periashutosh-prog/Restwise-Watch/README.md

# ⌚ Restwise

**A low-cost, radio-off wellbeing watch for students.**

Restwise shows one thing: today's schedule -- classes, meals, water breaks, and sleep windows -- synced from a companion website over USB and displayed on a small always-available wrist screen. No app to install, no notifications, no phone required to use it day-to-day. It runs on an ESP32-C6, and keeps WiFi and Bluetooth disabled during normal wear by design.

---

## 📋 Table of Contents

- [✨ Key Features](#-key-features)
- [🔩 Hardware Overview](#-hardware-overview)
- [🔌 Pin Mapping](#-pin-mapping)
- [🧠 Firmware Architecture](#-firmware-architecture)
- [🔄 Restwise Sync Protocol](#-restwise-sync-protocol)
- [📁 Repository Structure](#-repository-structure)
- [🛠️ Building & Flashing](#️-building--flashing)
- [📐 Technical Specifications](#-technical-specifications)
- [⚠️ Safety Notice](#️-safety-notice)
- [📄 License](#-license)

---

## ✨ Key Features

- 🔋 **Radio-off by default** -- WiFi and Bluetooth are explicitly disabled at boot (`WiFi.mode(WIFI_OFF); btStop();`), for continuous low-RF wear rather than as a cost-saving measure
- 🖥️ **Standalone timetable display** -- once synced, the watch shows the day's schedule entirely offline, browsable by day (Today, Monday..Saturday)
- 🔁 **Custom USB serial sync protocol** -- a small line-based handshake pushes a full week's schedule from the companion website to the watch in seconds, no companion app required
- 🕒 **RTC with graceful fallback** -- uses a DS3231 real-time clock when present; falls back to a software clock seeded at boot if the RTC isn't detected, so the watch never halts on a missing component
- 🌙 **Good Night screen** -- a passive night-time greeting with a crescent moon, shown automatically during configured night hours
- 🔐 **PIN lock & app suite** -- Stopwatch, Timer (with alert), Calculator (with a scientific mode), a lock-screen PIN gate, and a USB terminal console, all built on the same screen-state-machine UI
- 🔌 **Dual power path** -- runs from USB, battery, or both at once, via a diode-ORed supply feeding a single 3.3V regulator

---

## 🔩 Hardware Overview

| Component | Part |
|---|---|
| MCU | ESP32-C6-MINI-1-N4 |
| Display | 0.96" OLED, 128x64, SSD1306, I2C |
| RTC | DS3231 (optional at boot, software fallback if absent) |
| Input | 5-button D-pad (Up / Down / Left / Right / Center) |
| Regulator | AP2112K-3.3 LDO |
| Charging | External MCP73831-based charger board (see `PCB Files/`) |
| Storage | Onboard flash (LittleFS) for the synced timetable; EEPROM for settings |

---

## 🔌 Pin Mapping

| Signal | GPIO |
|---|---|
| SCL | 6 |
| SDA | 14 |
| Button -- Up | 23 |
| Button -- Down | 21 |
| Button -- Left | 19 |
| Button -- Right | 20 |
| Button -- Center | 3 |

> ℹ️ Only GPIO0-7 sit in the ESP32-C6's low-power (LP) domain and can wake the chip from *deep* sleep. Center (GPIO3) was deliberately placed in that range in case deep-sleep wake-on-press is added later. Light sleep has no such restriction and works on all five button pins.

All buttons are wired active-low to GND with internal pull-ups enabled in firmware -- no external resistors needed.

---

## 🧠 Firmware Architecture

The UI is a **screen-state machine**: a single `ScreenState` enum value tracks what's on screen at any moment, `drawScreen()` dispatches to the matching draw function, and every screen has its own `if/else` block in `loop()` for input handling. Transitions between screens use a simple offset-based slide animation.

**Screens included:** Watchface, Menu, Restwise (timetable + day view), Stopwatch, Timer (+ alert), Calculator (+ scientific mode), PIN entry, Security menu/confirm, Lock-screen settings, Terminal, and the Good Night screen.

Buttons are polled directly in `loop()` (50ms interval, which also serves as debounce) -- there's no RTOS task reading input separately.

---

## 🔄 Restwise Sync Protocol

A small, line-based ASCII protocol runs over the same USB serial connection used for flashing, active on every screen except the Terminal app (which owns Serial for its own console protocol while active):

```
Host -> ESP   RW_HELLO                          ESP -> Host   RW_HELLO
Host -> ESP   RW_TIME <YYYY-MM-DD HH:MM:SS>      ESP -> Host   RW_TIME_OK
Host -> ESP   RW_BEGIN                           ESP -> Host   RW_READY
Host -> ESP   C|<key>|<Name>                     (8 lines: the category names, e.g. C|school|School, C|free|Free time)
Host -> ESP   <days>:<category>|<startMin>|<endMin>|<label>  (repeated, one per line)
Host -> ESP   RW_END                             ESP -> Host   RW_OK <count>
```

`<label>` is the block's name as typed on the website (up to 19 characters, may be empty) and `<category>` is the key chosen in the website's dropdown: `school`, `tuition`, `homework`, `meal`, `break`, `sleep`, `free` or `travel`. The category is written after a colon in the first field so firmware that predates it still reads the day mask and ignores the rest; `C|` lines are skipped by older firmware as well. A block synced without a category (an older timetable) falls back to guessing its icon from the words in its name.

### The current-block screen

On waking from deep sleep (and from idle screen-off) the watch checks the timetable first: if a block is running it shows that block, otherwise the watchface. The screen has an icon on the left chosen by the block's category (book = school, tuition and homework; bowl = meal; moon = sleep; clock = free time; car = travel; bottle = break) and, on the right, the start-end time and the block's name. Only a night Sleep block says "Good Night!". The layout lives in `block_screen.h` and the icons in `block_icons.h` (generated from `UI-Screens/render_engine/block_ui.py`); `host-test/` runs the same code on a PC and checks it pixel-for-pixel against the approved renders.

### Two builds

`build_config.h` has a switch, `RESTWISE_NO_RADIO`. `python tools/build_variants.py both` compiles the full build (WiFi app, Discord, AI Chatbot, NTP) and the **no-radio build**, where none of that code is compiled in, from the same source.

Receiving a handshake auto-navigates the watch to the Restwise screen, since opening the serial port resets the chip back to the watchface. The received schedule is written straight to `/timetable.rw` on LittleFS and reloaded immediately once the transfer completes -- no reboot required.

### The AI chatbot's personality

The chatbot talks like a warm friend rather than a helpdesk: casual and short, on your side, it nudges you to sleep when it is late, and it says so honestly if you ask whether it is an AI. The persona is `AI_PERSONA_BASE` and `AI_PERSONA_STYLE` in `Restwise-watch.ino` (plain ASCII, under 40 words per reply). To make it personal, add an optional `AI_OWNER_PROFILE` to your **private** `ai_config.h` (see `ai_config.example.h`); it is never committed, but it is sent to Groq with every message, so keep it light. Full-radio build only: the no-radio build has no chatbot.

---

## 📁 Repository Structure

```
Restwise-watch/
├── Restwise-watch.ino    # Firmware source (this repo's main sketch)
├── block_screen.h        # Current-block screen, block lookup and name layout (shared with host-test/)
├── block_icons.h         # The six 40x40 block icons (generated)
├── build_config.h        # RESTWISE_NO_RADIO switch
├── tools/                # build_variants.py: compile the full and the no-radio build
├── host-test/            # Runs block_screen.h on a PC and compares it with the approved renders
├── PCB Files/            # Schematic, PCB layout, and Gerber/export files
├── README.md             # This file
└── LICENSE                # All Rights Reserved
```

---

## 🛠️ Building & Flashing

1. Install the **ESP32 board package** in Arduino IDE / `arduino-cli` (board: `esp32:esp32:esp32c6`).
2. Install the required libraries: `RTClib`, `Adafruit SSD1306`, `Adafruit GFX Library`.
3. Open `Restwise-watch.ino` and select the ESP32-C6 board + correct COM port.
4. Compile and upload.

```bash
arduino-cli compile --fqbn esp32:esp32:esp32c6 .
arduino-cli upload -p COMx --fqbn esp32:esp32:esp32c6 .
```

---

## 📐 Technical Specifications

| Spec | Value |
|---|---|
| MCU | ESP32-C6 |
| Flash usage | ~93% of 1.31MB (default partition scheme) |
| RAM usage | ~14% of 320KB |
| Display | 0.96" OLED, 128x64, I2C |
| Sync interface | USB serial (Web Serial API on the website side) |
| Radio | Off by default |

---

## ⚠️ Safety Notice

This project includes custom battery charging circuitry and a lithium battery. Building or operating a device from these files carries real electrical and fire risk if assembled incorrectly. Anyone building this does so entirely at their own risk. See `LICENSE` for the full disclaimer.

---

## 📄 License

**All Rights Reserved.** See [`LICENSE`](./LICENSE) for full terms. This repository is shared for viewing and evaluation only (e.g. school project review, competition judging, sponsorship review) -- no permission is granted to copy, modify, or redistribute any part of it without prior written consent.
