periashutosh-prog/Restwise-Watch/PCB Files/Schematic.pdf

R6

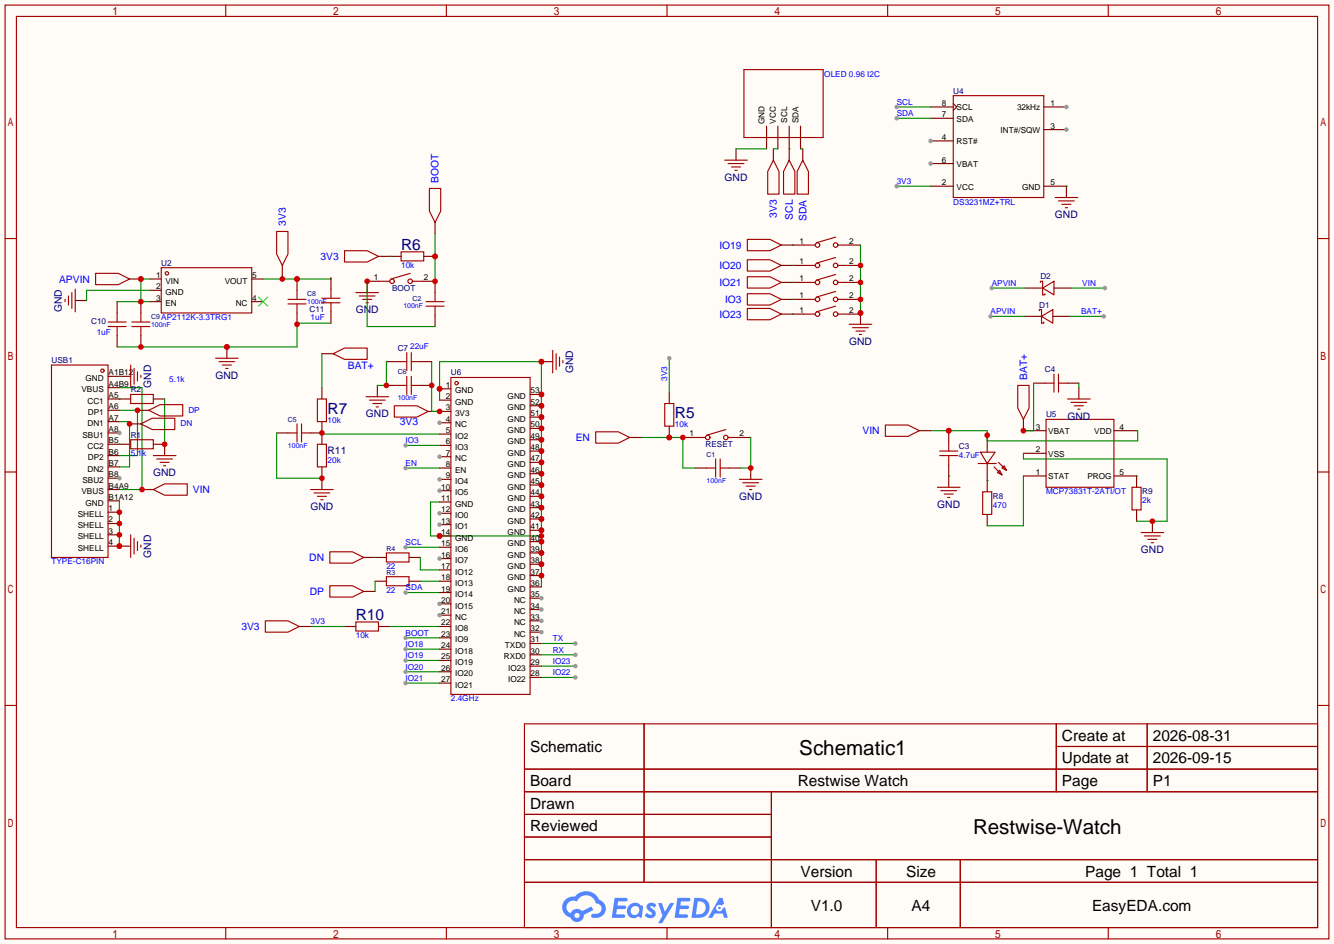
[picture p1: page 1]

Schematic | Schematic1 | Create at | 2026-08-31

Update at | 2026-09-15

Board | Restwise Watch | Page | P1
Drawn | | Restwise-Watch
Reviewed

Version | Size | Page 1 Total 1
V1.0 | A4 | EasyEDA.com
