periashutosh-prog/Restwise-Watch/Restwise-watch.ino

// Restwise - Restwise smartwatch firmware for the ESP32-C6 (custom PCB)
// Copyright (C) 2026 Ashutosh
//
// Port of StrawberryOS8266 (ESP8266 NodeMCU v1) to the ESP32-C6-MINI-1-N4
// custom Restwise PCB. All UI/app code is unchanged from the ESP8266 build;
// only the platform layer differs. See PORTING NOTES below.
//
// See the LICENSE file for more details.
//
// ---------------------------------------------------------------------------
// PORTING NOTES (ESP8266 NodeMCU v1 -> ESP32-C6 custom PCB)
// ---------------------------------------------------------------------------
// * WiFi library is <WiFi.h> (ESP32 core), not <ESP8266WiFi.h>. Radio-off is
//   now WiFi.mode(WIFI_OFF) + btStop() -- the ESP32-C6 also has BLE (unlike
//   the ESP8266), so both radios are explicitly killed, not just WiFi.
//   forceSleepBegin() doesn't exist on ESP32 and isn't needed: WIFI_OFF
//   already fully powers the radio down on this core.
// * EEPROM (settings) and LittleFS (Restwise timetable) work identically on
//   the ESP32 Arduino core -- no changes needed versus the ESP8266 version.
// * Buttons are still polled from loop(), same as the ESP8266 build (no
//   FreeRTOS reader task here either, for parity with that version).
// * The RTC stays OPTIONAL, same software-clock-from-millis() fallback as
//   before, seeded at 12:00 if no DS3231 answers on the bus.
// * Light sleep note: the ESP32-C6 *can* wake from light sleep on any GPIO
//   (unlike the ESP8266, which couldn't -- that's why the 8266 build dropped
//   sleep entirely). This port intentionally keeps the same behaviour as the
//   ESP8266 version for now (display-blank only, no MCU sleep) so the two
//   builds stay in parity. Real light-sleep power savings are a real ESP32-C6
//   capability worth adding later, not part of this port.
//
// WIRING (custom Restwise PCB, per schematic/netlist)
//   IO23 -> UP     IO21 -> DOWN   IO19 -> LEFT   IO20 -> RIGHT   IO3 -> CENTER
//   GPIO6 -> SCL   GPIO14 -> SDA
//   All buttons wire to GND (active-low, internal pull-ups -- no external
//   resistors needed).
//
//   Note: only GPIO0-7 are in the ESP32-C6's LP (low-power) domain and can
//   wake the chip from *deep* sleep. IO3 (CENTER) is the one button pin in
//   that range; it was deliberately chosen for CENTER for that reason, in
//   case deep-sleep wake-on-button-press is added later. Light sleep (see
//   note above) has no such restriction and works on all five button pins.
// ---------------------------------------------------------------------------
#include "build_config.h"   // RESTWISE_NO_RADIO switch (see tools/build_variants.py)
#include <Arduino.h>
#include <Wire.h>
#include <EEPROM.h>
#include <LittleFS.h>
#include <RTClib.h>
#include <Adafruit_SSD1306.h>
#include <Adafruit_GFX.h>
#include "esp_sleep.h"
#include <Preferences.h>
#ifndef RESTWISE_NO_RADIO
  #include <WiFi.h>
  #include <WiFiUdp.h>
  #include <HTTPClient.h>
  #include <WiFiClientSecure.h>
  #include <ArduinoJson.h>
  #include <WebSocketsClient.h>
#endif
#include "time.h"
#include "block_screen.h"   // the current-block screen and the block lookup (also run on the PC by host-test/)

#ifndef RESTWISE_NO_RADIO
// Groq API key + model, kept out of the repo (ai_config.h is gitignored).
#if __has_include("ai_config.h")
  #include "ai_config.h"
#else
  #error "Missing ai_config.h - copy ai_config.example.h to ai_config.h and add your Groq API key."
#endif

// Discord bot token (gitignored) and the public root certificates used to verify Discord's TLS.
#if __has_include("discord_config.h")
  #include "discord_config.h"
#else
  #error "Missing discord_config.h - copy discord_config.example.h to discord_config.h and add your bot token."
#endif
#include "discord_roots.h"
#endif  // RESTWISE_NO_RADIO

// Master switch for the "extras" that exist on the dev watch but should not
// ship: the WiFi app (false hard-blocks the radio from ever being enabled,
// even if the UI is reachable) and the Dino Game (false hides it from the
// Apps menu). Does NOT affect the boot-time WiFi.mode(WIFI_OFF)/btStop()
// below -- the watch is always radio-off at boot regardless.
#ifdef RESTWISE_NO_RADIO
const bool WIFI_APP_ENABLED = false;   // the no-radio build has no WiFi code at all
#else
const bool WIFI_APP_ENABLED = true;

// Name the watch shows up as on the router. Hostnames may only contain letters, digits and hyphens,
// so no apostrophe.
const char* const WIFI_HOSTNAME = "Ashutosh-Smartwatch";
#endif

// Used by the idle-blank / deep-sleep checks in loop(): is a radio feature in the middle of something?
#ifdef RESTWISE_NO_RADIO
  #define RW_RADIO_BUSY() (false)
  #define RW_HB_RADIO_FIELDS 0, 0, 0
#else
  #define RW_RADIO_BUSY() (currentScreen == SCREEN_WIFI_SCANNING || currentScreen == SCREEN_WIFI_PASSWORD || \
                           currentScreen == SCREEN_WIFI_NTP || aiBusy || dcBusy)
  #define RW_HB_RADIO_FIELDS (int)WiFi.status(), (int)dcGwConnected, (int)dcPresenceSent
#endif

#define SCREEN_WIDTH 128
#define SCREEN_HEIGHT 64
#define OLED_RESET -1
#define I2C_CLOCK_DISPLAY 1000000UL // see the I2C note below
#define I2C_CLOCK_RTC     400000UL
// The library forces its own bus speed around every frame (default 400kHz, then back to 100kHz),
// overriding Wire.setClock(), so the real speeds have to be passed here: 1MHz during the frame
// push, 400kHz after (what the RTC uses).
Adafruit_SSD1306 display(SCREEN_WIDTH, SCREEN_HEIGHT, &Wire, OLED_RESET, I2C_CLOCK_DISPLAY, I2C_CLOCK_RTC);

RTC_DS3231 rtc;

// I2C
#define PIN_SDA 14
#define PIN_SCL 6

// A full SSD1306 128x64 frame is 1024 GDDRAM bytes; the Adafruit driver adds a
// handful of command/control bytes per transfer (~1040 bytes total). Each I2C
// byte costs 9 bus clocks (8 data + 1 ACK), so one full-frame push costs
// ~1040*9 = 9360 bits. At a 40 FPS display target that's 9360*40 = 374,400 bps
// minimum with zero margin -- too tight to call comfortable once you add real
// I2C protocol overhead (repeated starts, clock stretching, buffer refills).
// Doubling that for real headroom lands at ~750kHz, so we run the bus at the
// nearest standard rate above it: 1MHz (Fast Mode Plus), which every SSD1306
// clone and the ESP32-C6's I2C peripheral both support.
//
// The DS3231 is NOT rated past 400kHz (Fast-mode) per its datasheet, so it
// can't share the bus at 1MHz. Since it sits on the same SDA/SCL lines as the
// OLED, the bus speed is switched down to 400kHz right around every RTC
// transaction and restored afterward -- see I2C_CLOCK_DISPLAY/I2C_CLOCK_RTC.

// Buttons (see wiring note above)
#define BTN_UP     23
#define BTN_DOWN   21
#define BTN_LEFT   19
#define BTN_RIGHT  20
#define BTN_CENTER 3

#define PIN_BATTERY_ADC 2 // IO2 = ADC1_CH2

bool buttonStates[5] = {false, false, false, false, false};
const uint8_t buttonPins[5] = {BTN_UP, BTN_DOWN, BTN_LEFT, BTN_RIGHT, BTN_CENTER};

uint8_t statusIndex = 0;
bool isStatusActive = false;

// --- Timekeeping ---------------------------------------------------------
// rtcPresent is decided once at boot. When there's no DS3231 on the bus the
// watch falls back to a software clock driven by millis(), based at 12:00, so
// it stays usable (and demo-able) instead of dying on a "RTC Error!" halt.
bool rtcPresent = false;
DateTime softBase(2026, 1, 1, 12, 0, 0);
unsigned long softBaseMillis = 0;

enum ScreenState {
  SCREEN_WATCHFACE, SCREEN_MENU, SCREEN_STOPWATCH, SCREEN_TIMER, SCREEN_TIMER_ALERT,
  SCREEN_CALCULATOR, SCREEN_CALCULATOR_SCI,
  SCREEN_PIN_ENTRY, SCREEN_SECURITY_MENU, SCREEN_SECURITY_CONFIRM,
  SCREEN_LOCK_SETTINGS, SCREEN_TERMINAL,
  SCREEN_RESTWISE, SCREEN_RESTWISE_DAY, SCREEN_BLOCK,
  SCREEN_ANIMATOR, SCREEN_BATTERY, SCREEN_BATTERY_INDICATOR, SCREEN_DINO,
  SCREEN_WIFI_CONFIRM, SCREEN_WIFI_SCANNING, SCREEN_WIFI_RESULTS,
  SCREEN_WIFI_PASSWORD, SCREEN_WIFI_KEYBOARD, SCREEN_WIFI_HOME,
  SCREEN_WIFI_TOGGLE_CONFIRM, SCREEN_WIFI_FORGET_CONFIRM, SCREEN_WIFI_NTP,
  SCREEN_AI_NOWIFI, SCREEN_AI_CHAT,
  SCREEN_DISCORD_NOWIFI, SCREEN_DISCORD_LIST, SCREEN_DISCORD_ADD, SCREEN_DISCORD_DELETE, SCREEN_DISCORD_CHAT,
  SCREEN_POWER_MENU, SCREEN_POWER_CONFIRM, SCREEN_ECO_CLOCK, SCREEN_ECO_EXIT, SCREEN_ECO_CRITICAL
};
ScreenState currentScreen = SCREEN_WATCHFACE;

bool buttonJustPressed[5] = {false, false, false, false, false};

// Written only by buttonTask, read by loop(). A press is latched until loop() takes it, so one
// that lands during a slow redraw or a slide animation is still seen instead of falling between polls.
// Task priorities: buttons (2) > the screen/UI loop (Arduino's loopTask, 1) > every background task (0).
// A lower number never pre-empts a higher one, so a TLS handshake, NTP sync or battery sample can only
// run in the gaps -- e.g. while the display transfer is in flight -- and never delays a press or a frame.
const UBaseType_t PRIO_BUTTONS = 2;
const UBaseType_t PRIO_BACKGROUND = 0;

const uint32_t BTN_SAMPLE_MS = 5;
const uint8_t  BTN_STABLE_SAMPLES = 4;    // 4 x 5ms = a level must hold 20ms to count (also the debounce)
const uint32_t BTN_PRESS_TTL_MS = 350;    // a latched press older than this is stale and dropped
volatile bool btnHeld[5] = {false, false, false, false, false};
volatile bool btnLatched[5] = {false, false, false, false, false};
volatile uint32_t btnLatchedAt[5] = {0, 0, 0, 0, 0};
// Diagnostics: raw level changes the sampler saw (chatter shows up as a huge count), debounced presses
// it accepted, and presses the UI loop actually took. A press that is accepted but never taken is a
// software gating problem; edges far above 2 per press means a bouncing / marginal contact.
volatile uint32_t btnEdges[5] = {0, 0, 0, 0, 0};
volatile uint32_t btnPresses[5] = {0, 0, 0, 0, 0};
volatile uint32_t btnTaken[5] = {0, 0, 0, 0, 0};

enum MenuApp {
  APP_RESTWISE, APP_STOPWATCH, APP_TIMER, APP_CALCULATOR, APP_ANIMATOR, APP_BATTERY, APP_POWER,
  APP_WIFI, APP_AI, APP_DISCORD, APP_DINO, APP_SECURITY, APP_LOCKSCREEN, APP_TERMINAL, APP_LOCK,
  NUM_MENU_APPS
};
const char* const menuAppNames[NUM_MENU_APPS] = {"Restwise", "Stopwatch", "Timer", "Calculator", "Animator", "Battery", "Power Mode", "WiFi", "AI Chatbot", "Discord", "Dino Game", "Security", "Lock Screen", "Terminal", "Lock"};
int menuApps[NUM_MENU_APPS]; // visible menu rows -> MenuApp, built once in buildMenu()
int menuCount = 0;
int menuIndex = 0;

void buildMenu() {
  menuCount = 0;
  for (int a = 0; a < NUM_MENU_APPS; a++) {
    if ((a == APP_DINO || a == APP_DISCORD) && !WIFI_APP_ENABLED) continue;
#ifdef RESTWISE_NO_RADIO
    if (a == APP_WIFI || a == APP_AI) continue;
#endif
    menuApps[menuCount++] = a;
  }
}

unsigned long swStartTime = 0;
unsigned long swElapsedTime = 0;
bool swRunning = false;
int swFocus = 0;

// Animator: a scripted, looping reel of predefined vector animations.
// Fully time-based (elapsed-ms driven), never frame-counted, so it stays
// smooth and reproducible regardless of loop jitter or frame rate.
int animatorSceneIndex = 0;
unsigned long animatorSceneStart = 0;
int animatorFps = 60; // user-selectable 10..60 in steps of 10

Preferences prefs;   // settings store: the power mode, the WiFi credentials (full build only) ...

#ifndef RESTWISE_NO_RADIO
// ---- WiFi app (ported from AIO_Transmitter's WiFi UI/keyboard/focus-nav) ----
// wifiEnabled reflects the user's explicit on/off choice for this session --
// never set true automatically. There is no boot-time auto-connect by design.
bool wifiEnabled       = false;
int  wifiScanResults   = 0;
int  wifiListIndex     = -1;
int  wifiListScroll    = 0;
String wifiTargetSSID  = "";
String wifiPassword    = "";
String wifiStatusMsg   = "";
bool wifiConnecting    = false;
unsigned long wifiScanStart        = 0;
unsigned long wifiConnectStartTime = 0;
int wifiHomeCursor     = -1;
int wifiConfirmCursor  = 0;
int wifiToggleCursor   = 0;
int wifiForgetCursor   = 1;
String wifiForgetTargetSSID = "";
int wifiPasswordCursor = 1;
int wifiRetryCount     = 0;

const int MAX_SAVED_NETS = 5;
String savedSSIDs[MAX_SAVED_NETS];
String savedPWDs[MAX_SAVED_NETS];
int savedNetCount = 0;
String lastConnectedSSID = "";

// Four independent, non-government NTP sources, queried in PARALLEL by four
// FreeRTOS tasks (raw SNTP over WiFiUDP -- bypasses the OS-level SNTP client
// entirely, sidestepping the stale-session class of bug that single-server
// configTime() hit). Whichever returns is used; if more than one has returned
// by the time we decide, the higher-priority one wins. Priority = list order
// (index 0 = highest).
const char* NTP_SERVERS[4] = {"time.google.com", "pool.ntp.org", "time.apple.com", "in.pool.ntp.org"};
const int NUM_NTP_SERVERS = 4;
const long  NTP_GMT_OFFSET_SEC = 19800; // IST (UTC+5:30)
const unsigned long NTP_TIMEOUT_MS = 20000;      // overall budget for all 4 tasks
const unsigned long NTP_PER_SERVER_TIMEOUT_MS = 8000; // one task's own UDP wait
const unsigned long NTP_RESULT_HOLD_MS = 5000;

volatile bool     ntpSlotDone[4]  = {false, false, false, false};
volatile bool     ntpSlotOk[4]    = {false, false, false, false};
volatile uint32_t ntpSlotEpoch[4] = {0, 0, 0, 0}; // Unix seconds, UTC

// Manual NTP Sync screen state. Polled non-blockingly (like the WiFi scan),
// never a single long blocking call -- that would freeze button polling and
// the "Syncing" animation for up to 20s straight.
int wifiNtpState = 0; // 0 = syncing, 1 = success, 2 = failed
int wifiNtpBestServer = -1; // index into NTP_SERVERS that actually provided the time
String wifiNtpResultMsg = "";
unsigned long wifiNtpStart  = 0;
unsigned long wifiNtpDoneAt = 0;

// Real internet reachability (not just "associated to an AP"), ported from
// AIO_Transmitter's connectivityTask -- rotates through 5 known 204-response
// endpoints, one check/sec, and treats internet as up if ANY of the last 5
// succeeded (so one dead endpoint doesn't false-negative the whole check).
bool internetOK    = false;
bool pingerStatus[5] = {false, false, false, false, false};
bool pingerStarted = false;

// 8x8 status icons for the watchface, MSB-first, one byte per row.
static const uint8_t PROGMEM wifi_bmp[] = {
  0x00, 0x7E, 0x81, 0x3C, 0x42, 0x18, 0x00, 0x18
};
static const uint8_t PROGMEM tower_bmp[] = {
  0x18, 0x24, 0x42, 0x18, 0x18, 0x18, 0x3C, 0x7E
};

// On-screen QWERTY keyboard (same grid/focus-nav as AIO_Transmitter's).
enum KBMode { KB_LOWER, KB_UPPER, KB_SYMBOL };
KBMode currentKBMode = KB_LOWER;
bool kbShiftOnce = false; // keyboard opened capitalised: reverts to lowercase after the first character
int kbCursorRow = 0, kbCursorCol = 0;
String kbInputBuffer = "";
int kbTextCursor   = 0;
int kbScrollOffset = 0;
ScreenState kbReturnScreen = SCREEN_WIFI_PASSWORD;

const char* kbLower[4][11] = {
  {"q","w","e","r","t","y","u","i","o","p","."},
  {"a","s","d","f","g","h","j","k","l",",","?"},
  {"z","x","c","v","b","n","m","<",">","^","BS"},
  {"1","2","3","4","5","6","7","8","9"," ","EN"}
};
const char* kbUpper[4][11] = {
  {"Q","W","E","R","T","Y","U","I","O","P","."},
  {"A","S","D","F","G","H","J","K","L",",","?"},
  {"Z","X","C","V","B","N","M","<",">","^","BS"},
  {"!","@","#","$","%","^","&","*","("," ","EN"}
};
const char* kbSymbol[4][11] = {
  {"1","2","3","4","5","6","7","8","9","0","~"},
  {"@","$","%","&","*","-","+","=","!","|","\\"},
  {"/","?",";",":","`","(",")","CL","CR","^","BS"},
  {"[","]","{","}","<",">","#","_","."," ","EN"}
};

// ---- AI Chatbot (ported from AIO_Transmitter) ----
// Transcript lives in plain globals: leaving the app and coming back keeps
// the thread, a reboot wipes it -- exactly the lifetime this needs.
struct AiMsg { bool fromUser; String text; };
const int AI_MAX_MSGS = 16;   // ring buffer; oldest drops off the top
const int AI_CTX_MSGS = 8;    // how many turns get resent as context
AiMsg aiMsgs[AI_MAX_MSGS];
int  aiMsgCount = 0;

// The chatbot's personality (its "system prompt"): a warm friend, not a helpdesk.
// AI_OWNER_PROFILE is OPTIONAL and lives in the gitignored ai_config.h, so personal details about the
// owner never reach this public repo; without it the persona is the same, just not personal.
// Keep all of this plain ASCII (the OLED font cannot draw anything else) and short: every request
// resends it and Groq counts the tokens.
#define AI_PERSONA_BASE \
  "You are a warm, easygoing friend chatting with the owner of this watch. " \
  "Talk like a real person, not a helpdesk: casual, short sentences, contractions, a little humour. " \
  "Never say 'as an AI', never offer a menu of options, never use lists. " \
  "Be on their side: listen first, encourage them, celebrate small wins, and be kind before giving advice. " \
  "Reply to what they actually said, and now and then ask one short follow-up. " \
  "This is a sleep watch, so if it is late, gently nudge them to rest. " \
  "If they sincerely ask whether you are an AI, say yes, plainly and kindly. " \
  "If they mention hurting themselves or being in danger, tell them to talk to a trusted adult right now."
#define AI_PERSONA_STYLE \
  " Replies show on a 128x64 pixel OLED: keep every reply under 40 words, plain ASCII only, " \
  "no markdown, no emoji, no curly quotes or long dashes."
#ifdef AI_OWNER_PROFILE
  #define AI_SYSTEM_PROMPT AI_PERSONA_BASE " About them: " AI_OWNER_PROFILE \
                           ". Use this naturally and never recite it back." AI_PERSONA_STYLE
#else
  #define AI_SYSTEM_PROMPT AI_PERSONA_BASE AI_PERSONA_STYLE
#endif

// Layout: header 0-12, transcript 13-48, input row 49-62.
const int AI_LINE_H     = 9;
const int AI_VIEW_TOP   = 14;
const int AI_VIEW_H     = 36;   // 14..49, 4 lines
const int AI_WRAP_CHARS = 20;   // 6px glyphs, leaving room for the focus border

int  aiFocus       = 1;   // -1 = "<--", 0 = message area, 1 = input box, 2 = SEND
bool aiScrollMode  = false;
int  aiScroll      = 0;
String aiInputText = "";

// UI thread <-> network task handshake. Each flag has exactly one writer at
// any point in the cycle, so no mutex is needed: the UI fills aiPendingBody
// and raises aiRequestPending, the task consumes it and raises aiReplyReady,
// the UI drains that and drops aiBusy.
volatile bool aiRequestPending = false;
volatile bool aiReplyReady     = false;
volatile bool aiBusy           = false;
String aiPendingBody;
String aiReplyText;
bool   aiTaskStarted = false;

#endif  // RESTWISE_NO_RADIO
enum TimerMode { TM_SETTING, TM_READY, TM_RUNNING, TM_RINGING };
TimerMode tmMode = TM_SETTING;
int tmHours = 0, tmMinutes = 0, tmSeconds = 0;
int tmActiveUnit = 2;
int tmFocus = 1;
unsigned long tmRemainingMillis = 0;
unsigned long tmLastTick = 0;
unsigned long tmSetPressStart = 0;
bool tmLongPressTriggered = false;

bool isAnimating = false;
int animOffsetY = 0;
int animTargetY = 0;
unsigned long animStartMs = 0;
const unsigned long SLIDE_MS = 250; // screen slide duration; time-based so it doesn't depend on frame cost
ScreenState animNextScreen = SCREEN_WATCHFACE;

unsigned long lastActivityTime = 0;
const int lockTimeoutOptions[4] = {5, 10, 15, 30};
int displayTimeoutSec = 5;
unsigned long DISPLAY_TIMEOUT_MS = 5000;

// After 90s of true inactivity the watch drops into deep sleep rather than
// just blanking the display. Only GPIO0-7 sit in the ESP32-C6's LP domain,
// so CENTER (GPIO3) is the only button physically capable of waking it from
// deep sleep -- UP/DOWN/LEFT/RIGHT cannot. Deep sleep is a full chip reset,
// so currentScreen's global initializer (SCREEN_WATCHFACE) is what actually
// guarantees "always wake on the watchface" -- nothing extra is needed for
// that part.
const unsigned long DEEP_SLEEP_TIMEOUT_MS = 90000;
bool displayOn = true;
int lockSettingsCursor = 0;

// Calculator variables
int calcCursorRow = 0, calcCursorCol = 0;
String calcInput1 = "";
String calcInput2 = "";
char calcOp = ' ';
bool calcIsOpSet = false;
bool calcError = false;

int calcSciRow = 0, calcSciCol = 0;

// SCI functions grid: 3 rows x 2 cols
const char* sciGrid[3][2] = {
  {"x^2",  "sqrt"},
  {"pi",   "x^3"},
  {"cbrt", "BACK"}
};

const char* calcGrid[5][4] = {
  {"7",   "8",  "9",   "/"},
  {"4",   "5",  "6",   "*"},
  {"1",   "2",  "3",   "-"},
  {"0",   ".",  "+",   "="},
  {"<--", "C",  "DEL", "SCI"}
};

// --- Security (PIN only) ---
enum SecurityFlow {
  SEC_NONE,
  SEC_LOCK,        // watchface -> menu gate
  SEC_VERIFY,      // enter current PIN (uses pendingAction)
  SEC_SET_NEW,     // enter new PIN
  SEC_SET_CONFIRM  // confirm new PIN
};
enum SecPendingAction { ACT_NONE, ACT_OPEN_MENU, ACT_CHANGE, ACT_DISABLE };
enum SecConfirmType { CONF_NONE, CONF_ENABLE, CONF_DISABLE };

SecurityFlow securityFlow = SEC_NONE;
SecPendingAction pendingAction = ACT_NONE;
SecConfirmType confirmType = CONF_NONE;
int confirmSelection = 1; // 0=Yes, 1=No
ScreenState pinReturnScreen = SCREEN_MENU;

bool pinSet = false;
String pinStored = "";
String pinBuffer = "";
String pinPendingNew = "";
int pinCursorRow = 0, pinCursorCol = 1;
String pinErrorMsg = "";
unsigned long pinErrorShownAt = 0;

int secMenuCursor = 0; // -1 = back, 0/1 = items

const char* pinKeys[4][3] = {
  {"7", "8", "9"},
  {"4", "5", "6"},
  {"1", "2", "3"},
  {"<", "0", "OK"}
};

// --- Settings storage (EEPROM) ---
#define EEPROM_SIZE 64
#define SETTINGS_MAGIC 0x52573031UL   // "RW01"

struct StoredSettings {
  uint32_t magic;
  uint8_t  pinSet;
  char     pin[5];      // 4 digits + NUL
  uint8_t  timeoutSec;
};

// --- Terminal (USB command console) ---
// Wire protocol from strawberry-terminal (Python): a line "CONFIRM <cmd> <args>"
// puts the watch into TERM_CONFIRM, showing <cmd>/<args> with a Yes/No prompt.
// The button choice is sent back as "ACK <cmd> YES" or "ACK <cmd> NO". Only
// "set_time <YYYY-MM-DD HH:MM:SS>" is understood right now.
enum TerminalState { TERM_IDLE, TERM_CONFIRM };
TerminalState termState = TERM_IDLE;
String termLineBuf = "";
String termPendingCmdName = "";
String termPendingArgs = "";
int termConfirmSelection = 0; // 0=Yes, 1=No

// strawberry-terminal sends "PING" every 2s while a session is open. A ping
// within the last 4s means a live host is attached; that's what flips the idle
// screen from "Listening" to "Connected!".
bool termConnected = false;
unsigned long termLastPingAt = 0;
const unsigned long TERM_PING_STALE_MS = 4000;

// --- Restwise (timetable app) --------------------------------------------
// The synced timetable is stored in LittleFS at /timetable.rw, one block per
// line: "<daysBitmask>[:<category>]|<startMin>|<endMin>|<label>". daysBitmask bit0=Mon .. bit6=Sun.
// startMin/endMin are minutes since midnight. Water breaks are just ordinary
// blocks in this list (the website already splits them in before syncing).
// <category> is the website's dropdown key (school, tuition, homework, meal, break, sleep, free, travel); it is
// written after a colon so a watch running older firmware still reads the number and ignores the rest.
// The file also holds "C|<key>|<Name>" lines: the category names, synced from the website.
#define RW_MAX_BLOCKS  2000   // 2000 x 28 bytes = 56 KB of RAM; the file on LittleFS needs about 30 bytes a block. Keep in step with WATCH_MAX_BLOCKS in static/js/home.js
#define RW_DAY_MAX      200   // max blocks shown for a single day
#define RW_DAY_ROWS       4   // visible timetable rows in the day view
#define RW_FILE "/timetable.rw"

typedef rwblk::Block RwBlock;   // days, startMin, endMin, label[20] (the name) and cat (the category), see block_screen.h
RwBlock rwBlocks[RW_MAX_BLOCKS];
int  rwDayIdx[RW_DAY_MAX];   // scratch list of one day's blocks (static, not on the stack: the loop task's stack is small)
int  rwBlockCount = 0;
bool rwHasData = false;

// Category names as synced from the website ("C|school|School" ...); the built-in names until the first sync.
char rwCatNames[rwblk::C_COUNT][rwblk::CAT_NAME_LEN];
void rwResetCatNames() {
  for (int i = 0; i < rwblk::C_COUNT; i++) {
    strncpy(rwCatNames[i], rwblk::CAT_DEFAULT_NAMES[i], rwblk::CAT_NAME_LEN - 1);
    rwCatNames[i][rwblk::CAT_NAME_LEN - 1] = '\0';
  }
}

// Which block is running now, looked up at most once a second (the screen redraws many times a second).
int  rwCachedBlock = -1;
bool rwCachedNight = false;       // night hours with no block running
unsigned long rwCachedAt = 0;
bool rwCacheDirty = true;         // set whenever the timetable or the clock changes

int  rwCursor = -1;          // -1 = back arrow, 0 = Today, 1..6 = Mon..Sat
int  rwSelectedDayItem = 0;  // which day-list item the day view is showing
int  rwDayScroll = 0;        // first visible timetable row in the day view

// Sync protocol (over USB serial, while the Restwise screen is active):
//   Host->ESP RW_HELLO   ESP->Host RW_HELLO      (connect / keep-alive ping)
//   Host->ESP RW_BEGIN   ESP->Host RW_READY      (start upload; file opened)
//   Host->ESP <block line> ... (repeated)        (written straight to the file)
//   Host->ESP RW_END     ESP->Host RW_OK <count> (file closed, reparsed)
enum RwSyncState { RWS_IDLE, RWS_RECV };
RwSyncState rwSyncState = RWS_IDLE;
String rwLineBuf = "";
bool rwConnected = false;
unsigned long rwLastHelloAt = 0;
const unsigned long RW_HELLO_STALE_MS = 4000;
File rwFile;
int rwRecvCount = 0;

void updateDisplay();
void drawCalculator(int yOffset);
void drawCalculatorSci(int yOffset);
void drawScreen(ScreenState screen, int yOffset);
void drawHeader(int yOffset, const char* appName = nullptr, bool backFocused = false);
void drawWatchFace(int yOffset);
void drawMenu(int yOffset);
void drawStopwatch(int yOffset);
void drawTimer(int yOffset);
void drawTimerAlert(int yOffset);
void drawCenteredText(Adafruit_SSD1306 &d, const String &text, int16_t y, uint8_t size = 1);
void drawBoxedCenteredText(Adafruit_SSD1306 &d, const char* text, int x, int y, int w, int h, bool inverted);
void startAnimation(ScreenState next, int targetOffset);
void readButtons();
bool takeButtonPress(int i);
void drawPinEntry(int yOffset);
void drawSecurityMenu(int yOffset);
void drawSecurityConfirm(int yOffset);
void handlePinSubmit();
void loadSettings();
void saveSettings();
void enterPinScreen(SecurityFlow flow, ScreenState returnTo);
void drawLockSettings(int yOffset);
void drawTerminal(int yOffset);
void processTerminalSerial();
void applyTerminalCommand(bool granted);
void setupButtons();
DateTime nowTime();
void setDeviceTime(const DateTime &dt);
void drawRestwise(int yOffset);
void drawRestwiseDay(int yOffset);
void drawBlockScreen(int yOffset);
ScreenState rwWakeScreen();
void drawAnimator(int yOffset);
void processRestwiseSerial();
void rwLoadFromFile();
int  rwBuildDayList(int dayIdx, int* out, int maxOut);
int  rwResolveDayIndex(int item);
const char* rwDayName(int item);
bool isNightNow();
void enterDeepSleep();
void drawBattery(int yOffset);
void drawBatteryIndicator(int yOffset);
void loadBatterySettings();
void saveBatterySettings();
void drawWifiConfirm(int yOffset);
void drawWifiScanning(int yOffset);
void drawWifiResults(int yOffset);
void drawWifiPassword(int yOffset);
void drawWifiKeyboard();
void drawWifiHome(int yOffset);
void drawWifiToggleConfirm(int yOffset);
void drawWifiForgetConfirm(int yOffset);
void loadCredentials();
void saveCredential(String ssid, String pwd);
void forgetCredential(String ssid);
String findSavedPwd(String ssid);
bool ntpQueryOnce(const char* host, uint32_t &outUnixTime, unsigned long timeoutMs);
void ntpQueryTask(void *pv);
void startNtpSync();
String aiToAscii(const String &in);
void aiAppendMsg(bool fromUser, const String &text);
String aiCallGroq(const String &body);
void aiChatTask(void *p);
void aiStartTask();
void aiSendMessage();
int aiRenderChat(int baseY, bool draw, int yOffset = 0);
void drawAiNoWifi(int yOffset);
void drawAiChat(int yOffset);
void drawWifiNTP(int yOffset);
void connectivityTask(void *p);
void startConnectivityPinger();
void drawWifiStatusIcon(int x, int y);
void drawTowerStatusIcon(int x, int y);
void drawBatteryIcon(int x, int y);
void drawBatteryStatusGlyph(int rightEdgeX, int y);

/* ---------------------------- Battery monitoring ---------------------------- */
// A dedicated FreeRTOS task samples the ADC 1000x/sec and posts one averaged
// reading per second -- kept off the main loop() so UI drawing and button
// polling are never blocked by sampling. Single writer (this task), single
// reader (everything else), so plain volatiles are enough -- no mutex needed.

// Divider: BAT+ --[10k]-- IO2 --[20k]-- GND, so Vbat = Vadc * (10k+20k)/20k.
// A 4.2V-charged cell lands at ~2.8V on IO2, comfortably inside the ADC's
// usable range under 11dB attenuation.
const float BATTERY_DIVIDER_RATIO = 1.5f;
const int BATTERY_SAMPLES_PER_SEC = 1000;

volatile float batteryVoltage = 0.0f;
volatile int batteryAdcRaw = 0;        // averaged raw 12-bit ADC count (0-4095), for display/debug
volatile int batteryAdcMilliVolts = 0; // averaged, calibrated pin voltage (pre-divider), for display/debug
volatile bool batteryReadingValid = false;

// Un-averaged "instant" readings, latched from a single sample every 100ms
// (every 100th tick of the same 1000Hz loop) -- shows the raw, jittery signal
// side by side with the smoothed Voltage/Est. Battery figures above.
volatile int   batteryAdcRawInstant   = 0;
volatile float batteryVoltageInstant  = 0.0f;

// Battery app UI state.
int  battCursor    = -1; // -1 = back box, 0 = "Indicator" row
int  battIndCursor = -1; // on SCREEN_BATTERY_INDICATOR: -1 = back, 0 = Icon box, 1 = %age box
bool battShowPercent = false; // false = watchface shows icon, true = shows "NN%" text

// Rolling ~8-second history of the once-a-second averages, used to detect a
// charging cell: CC/CV charging makes voltage climb steadily, so a clear rise
// across this window means "charging", not sensor noise on a single sample.
const int BATTERY_HISTORY_LEN = 8;
volatile float batteryHistory[BATTERY_HISTORY_LEN];
volatile int batteryHistoryCount = 0;
volatile int batteryHistoryHead = 0;
volatile bool batteryCharging = false;
const float BATTERY_CHARGE_RISE_THRESHOLD = 0.02f; // volts, over the history window

// Piecewise-linear 1S LiPo voltage -> percent curve at a moderate (~500mA-ish)
// discharge rate -- far more accurate near the ends than a naive linear
// 3.0V-4.2V map, since LiPo voltage sags fast at the bottom and plateaus
// through the middle.
struct BatteryCurvePoint { float voltage; int percent; };
const int NUM_BATTERY_CURVE_PTS = 11;
const BatteryCurvePoint batteryCurve[NUM_BATTERY_CURVE_PTS] = {
  {3.27f, 0}, {3.61f, 5}, {3.69f, 10}, {3.73f, 20}, {3.77f, 30}, {3.80f, 40},
  {3.84f, 50}, {3.87f, 60}, {3.95f, 70}, {4.08f, 85}, {4.20f, 100}
};

int batteryVoltageToPercent(float v) {
  if (v <= batteryCurve[0].voltage) return 0;
  if (v >= batteryCurve[NUM_BATTERY_CURVE_PTS - 1].voltage) return 100;
  for (int i = 0; i < NUM_BATTERY_CURVE_PTS - 1; i++) {
    if (v >= batteryCurve[i].voltage && v <= batteryCurve[i + 1].voltage) {
      float span = batteryCurve[i + 1].voltage - batteryCurve[i].voltage;
      float frac = (span > 0) ? (v - batteryCurve[i].voltage) / span : 0;
      return batteryCurve[i].percent + (int)(frac * (batteryCurve[i + 1].percent - batteryCurve[i].percent));
    }
  }
  return 0;
}

void batteryAdcTask(void *pvParameters) {
  analogReadResolution(12);
  analogSetPinAttenuation(PIN_BATTERY_ADC, ADC_11db);

  // Seed everything with one real sample right away. Without this, Voltage/
  // Est. Battery/the watchface icon would sit at 0 (uninitialized) for the
  // ~1s the first full 1000-sample average takes -- a visible jump from
  // empty-icon/"--" straight to the real level. The seed gets overwritten by
  // the first proper average a second later, so it only affects that first
  // instant on boot (and on every deep-sleep wake, which re-runs this task).
  {
    int mvSeed  = analogReadMilliVolts(PIN_BATTERY_ADC);
    int rawSeed = analogRead(PIN_BATTERY_ADC);
    float vSeed = (mvSeed / 1000.0f) * BATTERY_DIVIDER_RATIO;
    batteryVoltage        = vSeed;
    batteryAdcRaw         = rawSeed;
    batteryAdcMilliVolts  = mvSeed;
    batteryAdcRawInstant  = rawSeed;
    batteryVoltageInstant = vSeed;
    batteryReadingValid   = true;
  }

  for (;;) {
    uint32_t sumMv = 0, sumRaw = 0;
    for (int i = 0; i < BATTERY_SAMPLES_PER_SEC; i++) {
      int mvSample  = analogReadMilliVolts(PIN_BATTERY_ADC);
      int rawSample = analogRead(PIN_BATTERY_ADC);
      sumMv += mvSample;
      sumRaw += rawSample;

      if (i % 100 == 0) { // ~every 100ms: latch this single un-averaged sample
        batteryAdcRawInstant  = rawSample;
        batteryVoltageInstant = (mvSample / 1000.0f) * BATTERY_DIVIDER_RATIO;
      }

      vTaskDelay(1); // ~1ms tick -> ~1000 samples spread across ~1 second
    }
    float avgMilliVolts = (float)sumMv / BATTERY_SAMPLES_PER_SEC;
    float vBat = (avgMilliVolts / 1000.0f) * BATTERY_DIVIDER_RATIO;

    batteryVoltage = vBat;
    batteryAdcRaw = sumRaw / BATTERY_SAMPLES_PER_SEC;
    batteryAdcMilliVolts = (int)avgMilliVolts;
    batteryReadingValid = true;

    batteryHistory[batteryHistoryHead] = vBat;
    batteryHistoryHead = (batteryHistoryHead + 1) % BATTERY_HISTORY_LEN;
    if (batteryHistoryCount < BATTERY_HISTORY_LEN) batteryHistoryCount++;

    if (batteryHistoryCount == BATTERY_HISTORY_LEN) {
      int oldestIdx = batteryHistoryHead; // head now points at the oldest slot
      float oldest = batteryHistory[oldestIdx];
      batteryCharging = (vBat - oldest) > BATTERY_CHARGE_RISE_THRESHOLD;
    }
  }
}

// Small outline-plus-fill glyph, 4 segments. (x,y) is its top-left corner.
void drawBatteryIcon(int x, int y) {
  // While charging, the whole icon blinks (500ms on/off) instead of sitting
  // static, so a glance at the watchface shows charging state at a glance.
  if (batteryCharging && ((millis() / 500) % 2 == 1)) return;

  display.drawRect(x, y, 14, 8, SSD1306_WHITE);
  display.fillRect(x + 14, y + 2, 2, 4, SSD1306_WHITE); // + terminal nub

  int percent = batteryReadingValid ? batteryVoltageToPercent(batteryVoltage) : 0;
  int segments = (percent * 4 + 50) / 100;
  if (segments > 4) segments = 4;

  for (int i = 0; i < segments; i++) {
    display.fillRect(x + 1 + i * 3, y + 2, 2, 4, SSD1306_WHITE);
  }
}

// Watchface top-right battery status, in whichever mode the user picked on
// SCREEN_BATTERY_INDICATOR: the 4-segment icon, or plain "NN%" text.
// rightEdgeX is where the glyph's right edge should land.
void drawBatteryStatusGlyph(int rightEdgeX, int y) {
  if (!battShowPercent) {
    drawBatteryIcon(rightEdgeX - 16, y);
    return;
  }
  int percent = batteryReadingValid ? batteryVoltageToPercent(batteryVoltage) : 0;
  char buf[6];
  sprintf(buf, "%d%%", percent);
  display.setTextSize(1);
  display.setTextColor(SSD1306_WHITE);
  int16_t x1, y1; uint16_t w, h;
  display.getTextBounds(buf, 0, 0, &x1, &y1, &w, &h);
  display.setCursor(rightEdgeX - w - x1, y);
  display.print(buf);
}

// Battery screen content is taller than the 64px display, so it scrolls:
// focusing the back box shows the top rows, focusing the Indicator row
// scrolls down to reveal Raw ADC / Raw Voltage / Indicator at the bottom.
const int BATT_ROW_H = 12;
const int BATT_ROW_TOP = 18;
const int BATT_SCROLL_DOWN = 36;

void drawBattery(int yOffset) {
  bool backSel = (battCursor == -1);
  drawHeader(yOffset, "BATTERY", backSel);

  float v = batteryVoltage;
  int percent = batteryVoltageToPercent(v);
  int scrollY = (battCursor == -1) ? 0 : BATT_SCROLL_DOWN;

  display.setTextSize(1);
  display.setTextColor(SSD1306_WHITE);
  char buf[24];

  // Row 0: Voltage (averaged)
  int y = BATT_ROW_TOP + 0 * BATT_ROW_H - scrollY + yOffset;
  if (y >= 13 + yOffset) {
    display.setCursor(2, y);
    if (batteryReadingValid) sprintf(buf, "Voltage: %.2fV", v);
    else strcpy(buf, "Voltage: --");
    display.print(buf);
  }

  // Row 1: Est. Battery %
  y = BATT_ROW_TOP + 1 * BATT_ROW_H - scrollY + yOffset;
  if (y >= 13 + yOffset) {
    display.setCursor(2, y);
    if (batteryReadingValid) sprintf(buf, "Est. Battery: %d%%", percent);
    else strcpy(buf, "Est. Battery: --");
    display.print(buf);
  }

  // Row 2: ADC (averaged)
  y = BATT_ROW_TOP + 2 * BATT_ROW_H - scrollY + yOffset;
  if (y >= 13 + yOffset) {
    display.setCursor(2, y);
    if (batteryReadingValid) sprintf(buf, "ADC: %d (%dmV)", batteryAdcRaw, batteryAdcMilliVolts);
    else strcpy(buf, "ADC: --");
    display.print(buf);
  }

  // Row 3: Charging
  y = BATT_ROW_TOP + 3 * BATT_ROW_H - scrollY + yOffset;
  if (y >= 13 + yOffset) {
    display.setCursor(2, y);
    display.print("Charging: ");
    display.print(batteryCharging ? "True" : "False");
  }

  // Row 4: Raw ADC (un-averaged, 100ms)
  y = BATT_ROW_TOP + 4 * BATT_ROW_H - scrollY + yOffset;
  if (y >= 13 + yOffset) {
    display.setCursor(2, y);
    sprintf(buf, "Raw ADC: %d", batteryAdcRawInstant);
    display.print(buf);
  }

  // Row 5: Raw Voltage (un-averaged, 100ms)
  y = BATT_ROW_TOP + 5 * BATT_ROW_H - scrollY + yOffset;
  if (y >= 13 + yOffset) {
    display.setCursor(2, y);
    sprintf(buf, "Raw Voltage: %.2fV", batteryVoltageInstant);
    display.print(buf);
  }

  // Row 6: Indicator (focusable -- opens SCREEN_BATTERY_INDICATOR)
  y = BATT_ROW_TOP + 6 * BATT_ROW_H - scrollY + yOffset;
  if (y >= 13 + yOffset) {
    bool sel = (battCursor == 0);
    if (sel) { display.fillRect(0, y - 1, 128, BATT_ROW_H, SSD1306_WHITE); display.setTextColor(SSD1306_BLACK); }
    else      { display.setTextColor(SSD1306_WHITE); }
    display.setCursor(2, y);
    display.print("Indicator: ");
    display.print(battShowPercent ? "Percentage" : "Icon");
    display.setTextColor(SSD1306_WHITE);
  }

  // Scrollbar hint on the right edge -- two discrete positions (top/bottom).
  display.drawFastVLine(126, 13 + yOffset, 50, SSD1306_WHITE);
  int thumbY = 13 + yOffset + ((scrollY == 0) ? 0 : 30);
  display.fillRect(125, thumbY, 3, 20, SSD1306_WHITE);
}

void drawBatteryIndicator(int yOffset) {
  bool backSel = (battIndCursor == -1);
  drawHeader(yOffset, "Battery", backSel);
  display.setTextColor(SSD1306_WHITE);
  drawCenteredText(display, "Choose Battery", 22 + yOffset, 1);
  drawCenteredText(display, "Indicator", 32 + yOffset, 1);
  drawBoxedCenteredText(display, "ICON", 14, 48 + yOffset, 40, 13, (battIndCursor == 0));
  drawBoxedCenteredText(display, "%AGE", 74, 48 + yOffset, 40, 13, (battIndCursor == 1));
}

// Persisted via NVS (same Preferences mechanism as WiFi credentials) so the
// choice survives deep sleep -- deep sleep re-runs setup() from scratch, so a
// plain global would otherwise silently reset to "Icon" on every wake.
void loadBatterySettings() {
  prefs.begin("batt_set", true);
  battShowPercent = prefs.getBool("pct", false);
  prefs.end();
}

void saveBatterySettings() {
  prefs.begin("batt_set", false);
  prefs.putBool("pct", battShowPercent);
  prefs.end();
}

/* ---------------------------- Power modes ---------------------------- */
// Balanced = how the watch has always behaved. Power = never deep-sleeps, so WiFi (and Discord) stay
// up with modem sleep. Eco = extreme: 40 MHz, 5 FPS, a time-only screen for 5 s per wake, then deep sleep.
enum PowerMode { PM_BALANCED = 0, PM_POWER = 1, PM_ECO = 2 };
const char* const POWER_NAMES[3] = {"Balanced Mode", "Power Mode", "Eco Mode"};
const uint8_t POWER_TILE_MODE[3] = {PM_POWER, PM_BALANCED, PM_ECO}; // order shown in the Power Mode app

const float POWER_LOW_V = 3.45f;        // ~2% on the LiPo curve: auto-switch to Eco
const float POWER_LOW_REARM_V = 3.55f;  // that auto-switch re-arms once the cell climbs back above this
const float POWER_CRIT_V = 3.30f;       // ~0%: battery warning, then deep sleep
const float POWER_MIN_VALID_V = 2.5f;   // lower than this isn't a LiPo on the divider (e.g. no battery fitted)
const unsigned long ECO_AWAKE_MS = 5000;
const unsigned long ECO_EXIT_AWAKE_MS = 10000;
const int ECO_EXIT_PRESSES = 5;

uint8_t powerMode = PM_BALANCED, powerPrev = PM_BALANCED; // powerPrev = the mode to return to after Eco
bool powerCrit = false;       // the last deep sleep was the critical (<3.3 V) one
bool powerLowArmed = true;
float powerBootV = 0.0f;
int powerMenuCursor = 0;      // -1 back, 0..2 = tiles
int powerConfirmCursor = 1;   // 0 YES, 1 NO
uint8_t powerPending = PM_BALANCED;
int ecoPressCount = 0, ecoExitCursor = 1;
unsigned long ecoLastPressMs = 0;

void powerLoad() {
  prefs.begin("power", true);
  powerMode = prefs.getUChar("mode", PM_BALANCED);
  powerPrev = prefs.getUChar("prev", PM_BALANCED);
  powerCrit = prefs.getBool("crit", false);
  powerLowArmed = prefs.getBool("armed", true);
  prefs.end();
  if (powerMode > PM_ECO) powerMode = PM_BALANCED;
  if (powerPrev > PM_ECO) powerPrev = PM_BALANCED;
}

void powerSave() {
  prefs.begin("power", false);
  prefs.putUChar("mode", powerMode);
  prefs.putUChar("prev", powerPrev);
  prefs.putBool("crit", powerCrit);
  prefs.putBool("armed", powerLowArmed);
  prefs.end();
}

// A direct ADC average, read before the sampling task exists (Eco never starts it).
float powerReadBootVoltage() {
  analogReadResolution(12);
  analogSetPinAttenuation(PIN_BATTERY_ADC, ADC_11db);
  uint32_t sum = 0;
  for (int i = 0; i < 16; i++) { sum += analogReadMilliVolts(PIN_BATTERY_ADC); delay(2); }
  return (sum / 16.0f / 1000.0f) * BATTERY_DIVIDER_RATIO;
}

// Runs on every boot/wake, before anything else is configured.
void powerBootDecide(float v) {
  bool changed = false;
  bool valid = v > POWER_MIN_VALID_V;
  if (valid && v >= POWER_LOW_REARM_V && !powerLowArmed) { powerLowArmed = true; changed = true; }

  if (valid && powerCrit && v >= POWER_CRIT_V) {
    // Charged back above critical since the last critical sleep: leave Eco and resume the mode we were
    // in. If that mode was Eco itself there is nothing to restore -- it just keeps following Eco's rules.
    powerCrit = false;
    changed = true;
    if (powerPrev != PM_ECO) powerMode = powerPrev;
  }

  if (valid && v < POWER_CRIT_V) {
    if (powerMode != PM_ECO) powerPrev = powerMode;
    powerMode = PM_ECO;
    powerCrit = true;
    powerLowArmed = false;
    changed = true;
  }
  if (changed) powerSave();
}

// Eco and normal modes differ in CPU speed and radio state, so changing across that line restarts cleanly.
void powerRestartInto(uint8_t mode, bool crit, bool disarmLow) {
  if (mode == PM_ECO && powerMode != PM_ECO) powerPrev = powerMode;
  powerMode = mode;
  powerCrit = crit;
  if (disarmLow) powerLowArmed = false;
  powerSave();
  delay(50);
  ESP.restart();
}

void powerSelect(uint8_t m) {
  if (m == powerMode) return;
  if (m == PM_ECO) { powerRestartInto(PM_ECO, false, false); return; }
  powerMode = m;
  powerSave();
#ifndef RESTWISE_NO_RADIO
  if (WiFi.getMode() != WIFI_OFF) wifiApplyRadioSettings();
#endif  // RESTWISE_NO_RADIO
}

// Once a second while awake in Balanced/Power: step down to Eco on a low cell. Needs sustained readings,
// since a WiFi transmit burst can make the pack sag for a moment.
void powerBatteryWatch() {
  static unsigned long lastCheck = 0;
  static int lowCount = 0, critCount = 0;
  if (powerMode == PM_ECO) return;
  if (millis() - lastCheck < 1000) return;
  lastCheck = millis();
  if (!batteryReadingValid || batteryCharging) { lowCount = critCount = 0; return; }

  float v = batteryVoltage;
  bool valid = v > POWER_MIN_VALID_V;
  if (valid && v >= POWER_LOW_REARM_V && !powerLowArmed) { powerLowArmed = true; powerSave(); }
  critCount = (valid && v < POWER_CRIT_V) ? critCount + 1 : 0;
  lowCount  = (valid && v < POWER_LOW_V)  ? lowCount + 1  : 0;

  if (critCount >= 5) powerRestartInto(PM_ECO, true, true);
  else if (lowCount >= 10 && powerLowArmed) powerRestartInto(PM_ECO, false, true);
}

void ecoSleep() {
  display.clearDisplay();
  display.display(); // leave nothing in the panel's memory for the next wake
  enterDeepSleep();
}

// Eco owns its own sleep timer: ECO_AWAKE_MS after the last button activity, then deep sleep.
void ecoTick() {
  if (powerMode != PM_ECO) return;
  unsigned long limit = (currentScreen == SCREEN_ECO_EXIT) ? ECO_EXIT_AWAKE_MS : ECO_AWAKE_MS;
  if (millis() - lastActivityTime > limit) ecoSleep();
}

void ecoHandleButtons() {
  if (currentScreen == SCREEN_ECO_CLOCK) {
    if (buttonJustPressed[4]) {
      if (millis() - ecoLastPressMs > 2500) ecoPressCount = 0;
      ecoLastPressMs = millis();
      if (++ecoPressCount >= ECO_EXIT_PRESSES) {
        ecoPressCount = 0;
        ecoExitCursor = 1;
        currentScreen = SCREEN_ECO_EXIT; // no slide: at 5 FPS it would just stutter
      }
    }
  } else if (currentScreen == SCREEN_ECO_EXIT) {
    if (buttonJustPressed[2]) ecoExitCursor = 0;
    if (buttonJustPressed[3]) ecoExitCursor = 1;
    if (buttonJustPressed[4]) {
      if (ecoExitCursor == 0) powerRestartInto(powerPrev != PM_ECO ? powerPrev : PM_BALANCED, false, false);
      else currentScreen = SCREEN_ECO_CLOCK;
    }
  }
}

void drawEcoExit(int yOffset) {
  drawHeader(yOffset, "Power Mode", false);
  display.setTextSize(1);
  display.setTextColor(SSD1306_WHITE);
  drawCenteredText(display, "Exit Eco Mode?", 24 + yOffset, 1);
  drawBoxedCenteredText(display, "YES", 14, 44 + yOffset, 40, 14, (ecoExitCursor == 0));
  drawBoxedCenteredText(display, "NO",  74, 44 + yOffset, 40, 14, (ecoExitCursor == 1));
}

// A battery that nearly fills the screen with four partitions; only the last one left blinks.
void drawEcoCritical(int yOffset) {
  display.drawRect(2, 6 + yOffset, 116, 52, SSD1306_WHITE);
  display.drawRect(3, 7 + yOffset, 114, 50, SSD1306_WHITE);
  display.fillRect(118, 20 + yOffset, 7, 24, SSD1306_WHITE); // + terminal
  if ((millis() / 500) % 2 == 0) display.fillRect(8, 12 + yOffset, 24, 40, SSD1306_WHITE);
}

void drawPowerMenu(int yOffset) {
  drawHeader(yOffset, "Power Mode", powerMenuCursor == -1);
  display.setTextSize(1);
  for (int i = 0; i < 3; i++) {
    int y = 17 + i * 13 + yOffset;
    bool selected = (powerMenuCursor == i);
    if (selected) {
      display.fillRect(0, y - 1, 128, 12, SSD1306_WHITE);
      display.setTextColor(SSD1306_BLACK);
    } else {
      display.setTextColor(SSD1306_WHITE);
    }
    display.setCursor(4, y);
    display.print(POWER_NAMES[POWER_TILE_MODE[i]]);
    if (POWER_TILE_MODE[i] == powerMode) display.print(" (ON)");
  }
  display.setTextColor(SSD1306_WHITE);
}

void drawPowerConfirm(int yOffset) {
  drawHeader(yOffset, "Power Mode", false);
  display.setTextColor(SSD1306_WHITE);
  drawCenteredText(display, "Do you want to choose", 18 + yOffset, 1);
  drawCenteredText(display, String("\"") + POWER_NAMES[powerPending] + "\"?", 30 + yOffset, 1);
  drawBoxedCenteredText(display, "YES", 14, 48 + yOffset, 40, 13, (powerConfirmCursor == 0));
  drawBoxedCenteredText(display, "NO",  74, 48 + yOffset, 40, 13, (powerConfirmCursor == 1));
}

/* ---------------------------- Dino game ---------------------------- */
// Sprites: Chromium's own T-Rex/cactus art, body-cropped and downsampled 0.45x for the OLED.

// dinoStand: 18x19
const uint8_t dinoStand[] PROGMEM = {
  0x00, 0x3f, 0x80,   //           #######
  0x00, 0x6f, 0xc0,   //          ## ######
  0x00, 0x7f, 0xc0,   //          #########
  0x00, 0x7f, 0xc0,   //          #########
  0x00, 0x7f, 0xc0,   //          #########
  0x00, 0x7c, 0x00,   //          #####
  0x00, 0x7f, 0x00,   //          #######
  0x81, 0xf8, 0x00,   // #      ######
  0xc3, 0xfc, 0x00,   // ##    ########
  0xe7, 0xfc, 0x00,   // ###  #########
  0xff, 0xf8, 0x00,   // #############
  0xff, 0xf8, 0x00,   // #############
  0x7f, 0xf0, 0x00,   //  ###########
  0x3f, 0xf0, 0x00,   //   ##########
  0x1f, 0xe0, 0x00,   //    ########
  0x0f, 0xc0, 0x00,   //     ######
  0x0c, 0x60, 0x00,   //     ##   ##
  0x0c, 0x60, 0x00,   //     ##   ##
  0x0e, 0x70, 0x00,   //     ###  ###
};

// dinoBlink: 18x19
const uint8_t dinoBlink[] PROGMEM = {
  0x00, 0x3f, 0x80,   //           #######
  0x00, 0x7f, 0xc0,   //          #########
  0x00, 0x7f, 0xc0,   //          #########
  0x00, 0x7f, 0xc0,   //          #########
  0x00, 0x7f, 0xc0,   //          #########
  0x00, 0x7c, 0x00,   //          #####
  0x00, 0x7f, 0x00,   //          #######
  0x81, 0xf8, 0x00,   // #      ######
  0xc3, 0xfc, 0x00,   // ##    ########
  0xe7, 0xfc, 0x00,   // ###  #########
  0xff, 0xf8, 0x00,   // #############
  0xff, 0xf8, 0x00,   // #############
  0x7f, 0xf0, 0x00,   //  ###########
  0x3f, 0xf0, 0x00,   //   ##########
  0x1f, 0xe0, 0x00,   //    ########
  0x0f, 0xc0, 0x00,   //     ######
  0x0c, 0x60, 0x00,   //     ##   ##
  0x0c, 0x60, 0x00,   //     ##   ##
  0x0e, 0x70, 0x00,   //     ###  ###
};

// dinoRun1: 18x19
const uint8_t dinoRun1[] PROGMEM = {
  0x00, 0x3f, 0x80,   //           #######
  0x00, 0x6f, 0xc0,   //          ## ######
  0x00, 0x7f, 0xc0,   //          #########
  0x00, 0x7f, 0xc0,   //          #########
  0x00, 0x7f, 0xc0,   //          #########
  0x00, 0x7c, 0x00,   //          #####
  0x00, 0x7f, 0x00,   //          #######
  0x81, 0xf8, 0x00,   // #      ######
  0xc3, 0xfc, 0x00,   // ##    ########
  0xe7, 0xfc, 0x00,   // ###  #########
  0xff, 0xf8, 0x00,   // #############
  0xff, 0xf8, 0x00,   // #############
  0x7f, 0xf0, 0x00,   //  ###########
  0x3f, 0xf0, 0x00,   //   ##########
  0x1f, 0xe0, 0x00,   //    ########
  0x0f, 0xc0, 0x00,   //     ######
  0x0c, 0x60, 0x00,   //     ##   ##
  0x0c, 0x00, 0x00,   //     ##
  0x0e, 0x00, 0x00,   //     ###
};

// dinoRun2: 18x19
const uint8_t dinoRun2[] PROGMEM = {
  0x00, 0x3f, 0x80,   //           #######
  0x00, 0x6f, 0xc0,   //          ## ######
  0x00, 0x7f, 0xc0,   //          #########
  0x00, 0x7f, 0xc0,   //          #########
  0x00, 0x7f, 0xc0,   //          #########
  0x00, 0x7c, 0x00,   //          #####
  0x00, 0x7f, 0x00,   //          #######
  0x81, 0xf8, 0x00,   // #      ######
  0xc3, 0xfc, 0x00,   // ##    ########
  0xe7, 0xfc, 0x00,   // ###  #########
  0xff, 0xf8, 0x00,   // #############
  0xff, 0xf8, 0x00,   // #############
  0x7f, 0xf0, 0x00,   //  ###########
  0x3f, 0xf0, 0x00,   //   ##########
  0x1f, 0xe0, 0x00,   //    ########
  0x0f, 0xc0, 0x00,   //     ######
  0x0c, 0x60, 0x00,   //     ##   ##
  0x00, 0x60, 0x00,   //          ##
  0x00, 0x70, 0x00,   //          ###
};

// dinoDead: 18x19
const uint8_t dinoDead[] PROGMEM = {
  0x00, 0x3f, 0x80,   //           #######
  0x00, 0x57, 0xc0,   //          # # #####
  0x00, 0x6f, 0xc0,   //          ## ######
  0x00, 0x57, 0xc0,   //          # # #####
  0x00, 0x7f, 0xc0,   //          #########
  0x00, 0x7c, 0x00,   //          #####
  0x00, 0x7f, 0x00,   //          #######
  0x81, 0xf8, 0x00,   // #      ######
  0xc3, 0xfc, 0x00,   // ##    ########
  0xe7, 0xfc, 0x00,   // ###  #########
  0xff, 0xf8, 0x00,   // #############
  0xff, 0xf8, 0x00,   // #############
  0x7f, 0xf0, 0x00,   //  ###########
  0x3f, 0xf0, 0x00,   //   ##########
  0x1f, 0xe0, 0x00,   //    ########
  0x0f, 0xc0, 0x00,   //     ######
  0x0c, 0x60, 0x00,   //     ##   ##
  0x0c, 0x60, 0x00,   //     ##   ##
  0x0e, 0x70, 0x00,   //     ###  ###
};

// cactusS1: 7x15
const uint8_t cactusS1[] PROGMEM = {
  0x38,   //   ###
  0x38,   //   ###
  0x3a,   //   ### #
  0x3a,   //   ### #
  0xba,   // # ### #
  0xba,   // # ### #
  0xbe,   // # #####
  0xbe,   // # #####
  0xf8,   // #####
  0x78,   //  ####
  0x38,   //   ###
  0x38,   //   ###
  0x38,   //   ###
  0x38,   //   ###
  0x38,   //   ###
};

// cactusS2: 14x15
const uint8_t cactusS2[] PROGMEM = {
  0x30, 0x30,   //   ##      ##
  0x30, 0x30,   //   ##      ##
  0x37, 0xf4,   //   ## ####### #
  0x37, 0xf4,   //   ## ####### #
  0xb7, 0xf4,   // # ## ####### #
  0xb7, 0xf4,   // # ## ####### #
  0xbe, 0xf4,   // # ##### #### #
  0xbc, 0x7c,   // # ####   #####
  0xf8, 0x3c,   // #####     ####
  0x70, 0x30,   //  ###      ##
  0x30, 0x30,   //   ##      ##
  0x30, 0x30,   //   ##      ##
  0x30, 0x30,   //   ##      ##
  0x30, 0x30,   //   ##      ##
  0x30, 0x30,   //   ##      ##
};

// cactusS3: 22x15
const uint8_t cactusS3[] PROGMEM = {
  0x30, 0x30, 0x30,   //   ##      ##      ##
  0x38, 0x30, 0x70,   //   ###     ##     ###
  0x3e, 0xb1, 0xf4,   //   ##### # ##   ##### #
  0x3e, 0xb5, 0xf4,   //   ##### # ## # ##### #
  0xbe, 0xb5, 0xf4,   // # ##### # ## # ##### #
  0xbe, 0xb5, 0xf4,   // # ##### # ## # ##### #
  0xbe, 0xb5, 0xf4,   // # ##### # ## # ##### #
  0xbc, 0xb4, 0xfc,   // # ####  # ## #  ######
  0xf8, 0xb4, 0x7c,   // #####   # ## #   #####
  0x78, 0xf4, 0x70,   //  ####   #### #   ###
  0x38, 0x7c, 0x70,   //   ###    #####   ###
  0x38, 0x38, 0x70,   //   ###     ###    ###
  0x38, 0x30, 0x70,   //   ###     ##     ###
  0x38, 0x30, 0x70,   //   ###     ##     ###
  0x38, 0x30, 0x70,   //   ###     ##     ###
};

// cactusL1: 10x22
const uint8_t cactusL1[] PROGMEM = {
  0x0c, 0x00,   //     ##
  0x1e, 0x00,   //    ####
  0x1e, 0x00,   //    ####
  0x1e, 0x00,   //    ####
  0x1e, 0x00,   //    ####
  0x1e, 0xc0,   //    #### ##
  0xde, 0xc0,   // ## #### ##
  0xde, 0xc0,   // ## #### ##
  0xde, 0xc0,   // ## #### ##
  0xde, 0xc0,   // ## #### ##
  0xde, 0xc0,   // ## #### ##
  0xde, 0xc0,   // ## #### ##
  0xff, 0x80,   // #########
  0x7f, 0x00,   //  #######
  0x1e, 0x00,   //    ####
  0x1e, 0x00,   //    ####
  0x1e, 0x00,   //    ####
  0x1e, 0x00,   //    ####
  0x1e, 0x00,   //    ####
  0x1e, 0x00,   //    ####
  0x1e, 0x00,   //    ####
  0x1e, 0x00,   //    ####
};

// cactusL2: 22x22
const uint8_t cactusL2[] PROGMEM = {
  0x0e, 0x01, 0xc0,   //     ###        ###
  0x0e, 0x01, 0xc0,   //     ###        ###
  0x0e, 0x09, 0xc0,   //     ###     #  ###
  0x0e, 0x1d, 0xc0,   //     ###    ### ###
  0x0e, 0x1d, 0xc0,   //     ###    ### ###
  0x4e, 0xdd, 0xcc,   //  #  ### ## ### ###  ##
  0xce, 0xdd, 0xcc,   // ##  ### ## ### ###  ##
  0xce, 0xdd, 0xcc,   // ##  ### ## ### ###  ##
  0xce, 0xdd, 0xcc,   // ##  ### ## ### ###  ##
  0xce, 0xcf, 0xcc,   // ##  ### ##  ######  ##
  0xce, 0xcf, 0xcc,   // ##  ### ##  ######  ##
  0xce, 0xc3, 0xcc,   // ##  ### ##    ####  ##
  0xff, 0x81, 0xf8,   // #########      ######
  0x7e, 0x01, 0xf0,   //  ######        #####
  0x1e, 0x01, 0xc0,   //    ####        ###
  0x0e, 0x01, 0xc0,   //     ###        ###
  0x0e, 0x01, 0xc0,   //     ###        ###
  0x0e, 0x01, 0xc0,   //     ###        ###
  0x0e, 0x01, 0xc0,   //     ###        ###
  0x0e, 0x01, 0xc0,   //     ###        ###
  0x1e, 0x01, 0xc0,   //    ####        ###
  0x1e, 0x01, 0xc0,   //    ####        ###
};

// cactusL3: 33x22
const uint8_t cactusL3[] PROGMEM = {
  0x0e, 0x00, 0x00, 0x38, 0x00,   //     ###                   ###
  0x0e, 0x03, 0x00, 0x38, 0x00,   //     ###       ##          ###
  0x0e, 0x07, 0x00, 0x38, 0x00,   //     ###      ###          ###
  0x0e, 0x07, 0x41, 0xb8, 0x00,   //     ###      ### #     ## ###
  0x0e, 0x07, 0x61, 0xb8, 0x00,   //     ###      ### ##    ## ###
  0x0e, 0xc7, 0x61, 0xb9, 0x80,   //     ### ##   ### ##    ## ###  ##
  0xce, 0xc7, 0x61, 0xb9, 0x80,   // ##  ### ##   ### ##    ## ###  ##
  0xce, 0xd7, 0x61, 0xb9, 0x80,   // ##  ### ## # ### ##    ## ###  ##
  0xce, 0xdf, 0xc1, 0xb9, 0x80,   // ##  ### ## #######     ## ###  ##
  0xce, 0xdf, 0x19, 0xf9, 0x80,   // ##  ### ## #####   ##  ######  ##
  0xce, 0xdf, 0x19, 0xf9, 0x80,   // ##  ### ## #####   ##  ######  ##
  0xce, 0xdf, 0x5a, 0xf9, 0x80,   // ##  ### ## ##### # ## # #####  ##
  0xff, 0xdf, 0x7a, 0x3f, 0x00,   // ########## ##### #### #   ######
  0x7f, 0x9f, 0x7a, 0x3e, 0x00,   //  ########  ##### #### #   #####
  0x3e, 0x0f, 0x7a, 0x38, 0x00,   //   #####     #### #### #   ###
  0x0e, 0x07, 0x7e, 0x38, 0x00,   //     ###      ### ######   ###
  0x0e, 0x07, 0x3c, 0x38, 0x00,   //     ###      ###  ####    ###
  0x0e, 0x07, 0x18, 0x38, 0x00,   //     ###      ###   ##     ###
  0x0e, 0x07, 0x18, 0x38, 0x00,   //     ###      ###   ##     ###
  0x0e, 0x07, 0x18, 0x38, 0x00,   //     ###      ###   ##     ###
  0x0e, 0x07, 0x18, 0x38, 0x00,   //     ###      ###   ##     ###
  0x1e, 0x03, 0x08, 0x38, 0x00,   //    ####       ##    #     ###
};

const int DINO_W = 18, DINO_H = 19, DINO_X = 10;
const int DINO_FEET_Y = 61; // last pixel row of every sprite; the horizon line is drawn on row 62
const float DINO_GRAVITY = 906.25f; // px/s^2
const float DINO_JUMP_V = 252.0f;   // px/s -> ~35px apex, ~0.56s airtime
const float DINO_AIR_TIME = 2.0f * DINO_JUMP_V / DINO_GRAVITY;
const float DINO_SPEED_START = 100.0f; // px/s
const float DINO_SPEED_MAX = 190.0f;
const float DINO_ACCEL = 0.75f;        // px/s gained per second
const float DINO_FIRST_OBSTACLE_SEC = 1.4f;
const unsigned long DINO_CRASH_HOLD_MS = 700;
const int DINO_MAX_CACTI = 4;
const int DINO_MAX_SCORE = 99999;
const char* const DINO_HI_FILE = "/dino_hi.txt";

struct DinoCactusDef { const uint8_t* bmp; uint8_t w, h; };
const DinoCactusDef dinoCactusDefs[6] = {
  {cactusS1, 7, 15}, {cactusS2, 14, 15}, {cactusS3, 22, 15},
  {cactusL1, 10, 22}, {cactusL2, 22, 22}, {cactusL3, 33, 22}
};
struct DinoCactus { int spawnScroll; uint8_t type; bool active; }; // spawnScroll = whole-pixel scroll counter at spawn
struct DinoBox { int8_t x0, x1, r0, r1; }; // sprite-local columns [x0,x1) and rows [r0,r1)
const DinoBox dinoBoxes[3] = { {9, 16, 1, 6}, {1, 12, 7, 15}, {4, 11, 15, 19} }; // head, body, feet

enum DinoState { DINO_READY, DINO_PLAYING, DINO_PAUSED, DINO_CRASHED, DINO_OVER };
DinoState dinoState = DINO_READY;
int  dinoCursor = 1; // -1 back, 0 left box, 1 right box
int  dinoHigh = 0;
int  dinoScore = 0;
float dinoY = 0, dinoVy = 0;
float dinoSpeed = DINO_SPEED_START, dinoDist = 0, dinoRunSec = 0, dinoGroundScroll = 0;
float dinoTravel = 0, dinoLastW = 0, dinoNextGap = 0;
bool dinoSpawnedAny = false;
int8_t dinoLastCat[2] = {-1, -1}; // last two spawned kinds (0 small, 1 large)
unsigned long dinoLastTick = 0, dinoCrashedAt = 0;
DinoCactus dinoCacti[DINO_MAX_CACTI];
uint8_t dinoBumps[32]; // 256-bit ground-bump pattern, scrolls with the world

int dinoRand(int lo, int hi) { return lo + (int)(esp_random() % (uint32_t)(hi - lo + 1)); }
float dinoRandf() { return (esp_random() % 10000) / 10000.0f; }

// The high score lives in a file on the same LittleFS partition the Restwise timetable uses.
int dinoLoadHigh() {
  File f = LittleFS.open(DINO_HI_FILE, "r");
  if (!f) return 0;
  int v = f.parseInt();
  f.close();
  return constrain(v, 0, DINO_MAX_SCORE);
}

void dinoSaveHigh(int v) {
  File f = LittleFS.open(DINO_HI_FILE, "w");
  if (!f) return;
  f.print(v);
  f.close();
}

void dinoMakeBumps() {
  memset(dinoBumps, 0, sizeof(dinoBumps));
  for (int i = 0; i < 256; ) {
    if (dinoRand(0, 99) < 9) {
      int len = dinoRand(1, 3);
      for (int k = 0; k < len; k++) { int p = (i + k) & 255; dinoBumps[p >> 3] |= (1 << (p & 7)); }
      i += len + 4;
    } else {
      i++;
    }
  }
}

void dinoReset() {
  dinoY = 0; dinoVy = 0; dinoScore = 0;
  dinoSpeed = DINO_SPEED_START; dinoDist = 0; dinoRunSec = 0; dinoGroundScroll = 0;
  dinoTravel = 0; dinoLastW = 0; dinoNextGap = 0; dinoSpawnedAny = false;
  dinoLastCat[0] = dinoLastCat[1] = -1;
  for (int i = 0; i < DINO_MAX_CACTI; i++) dinoCacti[i].active = false;
  dinoMakeBumps();
}

void dinoOpen() {
  dinoHigh = dinoLoadHigh();
  dinoReset();
  dinoState = DINO_READY;
  dinoCursor = 1;
}

void dinoStart(bool withJump) {
  dinoReset();
  dinoState = DINO_PLAYING;
  dinoLastTick = millis();
  if (withJump) dinoVy = DINO_JUMP_V;
}

void dinoJump() {
  if (dinoY <= 0.0f && dinoVy <= 0.0f) dinoVy = DINO_JUMP_V;
}

void dinoSpawn() {
  int slot = -1;
  for (int i = 0; i < DINO_MAX_CACTI; i++) if (!dinoCacti[i].active) { slot = i; break; }
  if (slot < 0) return;

  int cat = (dinoRand(0, 99) < 45) ? 1 : 0;
  if (dinoLastCat[0] == cat && dinoLastCat[1] == cat) cat = 1 - cat; // never three of a kind in a row
  // Big groups only once the world is fast enough that a jump can clear their width.
  int maxSize = 3;
  if (cat == 1) maxSize = (dinoSpeed >= 170.0f) ? 3 : ((dinoSpeed >= 140.0f) ? 2 : 1);
  int type = cat * 3 + dinoRand(1, maxSize) - 1;

  dinoCacti[slot] = {(int)dinoGroundScroll, (uint8_t)type, true};
  dinoLastCat[1] = dinoLastCat[0];
  dinoLastCat[0] = cat;

  dinoLastW = dinoCactusDefs[type].w;
  float minGap = dinoSpeed * DINO_AIR_TIME + 0.4f * dinoLastW; // at least one full jump of room
  dinoNextGap = minGap * (1.0f + 0.6f * dinoRandf());
  dinoTravel = 0;
  dinoSpawnedAny = true;
}

// Ground and cacti both derive from the same whole-pixel scroll counter, so every frame they move
// by exactly the same number of pixels and can't shimmer against each other.
int dinoCactusX(int idx) { // takes an index, not the struct: Arduino hoists prototypes above type definitions
  return 128 - ((int)dinoGroundScroll - dinoCacti[idx].spawnScroll);
}

bool dinoHitsCactus(int idx) {
  const DinoCactus &c = dinoCacti[idx];
  const DinoCactusDef &d = dinoCactusDefs[c.type];
  int x = dinoCactusX(idx);
  int cx0 = x + 1, cx1 = x + d.w - 1; // inset 1px so empty arm corners don't count
  int cy0 = DINO_FEET_Y - d.h + 1, cy1 = DINO_FEET_Y + 1;
  int top = DINO_FEET_Y - DINO_H + 1 - (int)(dinoY + 0.5f);
  for (int i = 0; i < 3; i++) {
    int bx0 = DINO_X + dinoBoxes[i].x0, bx1 = DINO_X + dinoBoxes[i].x1;
    int by0 = top + dinoBoxes[i].r0,    by1 = top + dinoBoxes[i].r1;
    if (bx1 > cx0 && bx0 < cx1 && by1 > cy0 && by0 < cy1) return true;
  }
  return false;
}

void dinoCrash() {
  dinoState = DINO_CRASHED;
  dinoCrashedAt = millis();
  if (dinoScore > dinoHigh) {
    dinoHigh = dinoScore;
    dinoSaveHigh(dinoHigh);
  }
}

void dinoTick() {
  if (dinoState == DINO_CRASHED) {
    if (millis() - dinoCrashedAt >= DINO_CRASH_HOLD_MS) { dinoState = DINO_OVER; dinoCursor = 1; }
    return;
  }
  if (dinoState != DINO_PLAYING) return;

  unsigned long now = millis();
  float dt = (now - dinoLastTick) / 1000.0f;
  if (dt <= 0.0f) return;
  dinoLastTick = now;
  if (dt > 0.05f) dt = 0.05f;

  if (dinoY > 0.0f || dinoVy > 0.0f) {
    dinoVy -= DINO_GRAVITY * dt;
    dinoY += dinoVy * dt;
    if (dinoY <= 0.0f) { dinoY = 0.0f; dinoVy = 0.0f; }
  }
  if (dinoSpeed < DINO_SPEED_MAX) dinoSpeed = min(DINO_SPEED_MAX, dinoSpeed + DINO_ACCEL * dt);

  float step = dinoSpeed * dt;
  dinoDist += step;
  dinoRunSec += dt;
  dinoGroundScroll += step;
  dinoScore = min(DINO_MAX_SCORE, (int)(dinoDist * 0.1f));

  for (int i = 0; i < DINO_MAX_CACTI; i++) {
    if (!dinoCacti[i].active) continue;
    if (dinoCactusX(i) + dinoCactusDefs[dinoCacti[i].type].w < 0) dinoCacti[i].active = false;
  }

  if (!dinoSpawnedAny) {
    if (dinoRunSec >= DINO_FIRST_OBSTACLE_SEC) dinoSpawn();
  } else {
    dinoTravel += step;
    if (dinoTravel >= dinoLastW + dinoNextGap) dinoSpawn();
  }

  for (int i = 0; i < DINO_MAX_CACTI; i++) {
    if (dinoCacti[i].active && dinoHitsCactus(i)) { dinoCrash(); return; }
  }
}

void dinoHandleButtons() {
  switch (dinoState) {
    case DINO_READY:
      if (buttonJustPressed[0]) dinoStart(true);
      if (buttonJustPressed[4]) startAnimation(SCREEN_MENU, 64);
      break;

    case DINO_PLAYING:
      if (buttonJustPressed[0]) dinoJump();
      if (buttonJustPressed[4]) { dinoState = DINO_PAUSED; dinoCursor = 0; }
      break;

    case DINO_CRASHED:
      break;

    case DINO_PAUSED:
    case DINO_OVER:
      if (buttonJustPressed[0]) dinoCursor = -1;
      if (buttonJustPressed[1] && dinoCursor == -1) dinoCursor = 0;
      if (buttonJustPressed[2]) dinoCursor = 0;
      if (buttonJustPressed[3]) dinoCursor = 1;
      if (buttonJustPressed[4]) {
        if (dinoCursor == -1) {
          startAnimation(SCREEN_MENU, 64);
        } else if (dinoState == DINO_PAUSED) {
          if (dinoCursor == 0) { dinoLastTick = millis(); dinoState = DINO_PLAYING; }
          else startAnimation(SCREEN_MENU, 64);
        } else {
          if (dinoCursor == 0) startAnimation(SCREEN_MENU, 64);
          else dinoStart(false);
        }
      }
      break;
  }
}

void drawDinoHeader(int yOffset, bool backFocused) {
  display.drawFastHLine(0, 12 + yOffset, 128, SSD1306_WHITE);
  display.setTextSize(1);
  if (backFocused) {
    display.fillRect(0, yOffset, 24, 12, SSD1306_WHITE);
    display.setTextColor(SSD1306_BLACK);
  } else {
    display.setTextColor(SSD1306_WHITE);
  }
  display.setCursor(2, 2 + yOffset);
  display.print("<--");
  display.setTextColor(SSD1306_WHITE);
  display.setCursor(28, 2 + yOffset);
  display.print("Dino Game");

  char buf[12];
  sprintf(buf, dinoHigh >= 10000 ? "HI%d" : "HI %d", dinoHigh);
  int16_t x1, y1; uint16_t w, h;
  display.getTextBounds(buf, 0, 0, &x1, &y1, &w, &h);
  display.setCursor(127 - w - x1, 2 + yOffset);
  display.print(buf);
}

void drawDinoGameOver(int yOffset) {
  display.setTextColor(SSD1306_WHITE);
  drawCenteredText(display, "GAME OVER", 15 + yOffset, 2);
  char buf[24];
  sprintf(buf, "High Score: %d", dinoHigh);
  drawCenteredText(display, buf, 31 + yOffset, 1);
  sprintf(buf, "Score: %d", dinoScore);
  drawCenteredText(display, buf, 40 + yOffset, 1);
  drawBoxedCenteredText(display, "EXIT", 6, 50 + yOffset, 44, 13, (dinoCursor == 0));
  drawBoxedCenteredText(display, "PLAY AGAIN", 56, 50 + yOffset, 66, 13, (dinoCursor == 1));
}

void drawDino(int yOffset) {
  bool menuState = (dinoState == DINO_PAUSED || dinoState == DINO_OVER);
  drawDinoHeader(yOffset, menuState && dinoCursor == -1);
  display.setTextSize(1);
  display.setTextColor(SSD1306_WHITE);

  if (dinoState == DINO_OVER) { drawDinoGameOver(yOffset); return; }

  display.drawFastHLine(0, 62 + yOffset, 128, SSD1306_WHITE);
  int scroll = (int)dinoGroundScroll;
  for (int x = 0; x < 128; x++) {
    int p = (x + scroll) & 255;
    if (dinoBumps[p >> 3] & (1 << (p & 7))) display.drawPixel(x, 63 + yOffset, SSD1306_WHITE);
  }

  for (int i = 0; i < DINO_MAX_CACTI; i++) {
    if (!dinoCacti[i].active) continue;
    const DinoCactusDef &d = dinoCactusDefs[dinoCacti[i].type];
    display.drawBitmap(dinoCactusX(i), DINO_FEET_Y - d.h + 1 + yOffset, d.bmp, d.w, d.h, SSD1306_WHITE);
  }

  const uint8_t *spr;
  if (dinoState == DINO_CRASHED) spr = dinoDead;
  else if (dinoState == DINO_READY) spr = ((millis() / 150) % 12 == 0) ? dinoBlink : dinoStand;
  else if (dinoY > 0.0f) spr = dinoStand;
  else spr = (((int)(dinoRunSec * 12.0f)) & 1) ? dinoRun2 : dinoRun1;
  // The apex reaches into the header bar, so draw row by row and skip rows above the header line.
  int dinoTop = DINO_FEET_Y - DINO_H + 1 - (int)(dinoY + 0.5f) + yOffset;
  const int bytesPerRow = (DINO_W + 7) / 8;
  for (int r = 0; r < DINO_H; r++) {
    if (dinoTop + r <= 12 + yOffset) continue;
    display.drawBitmap(DINO_X, dinoTop + r, spr + r * bytesPerRow, DINO_W, 1, SSD1306_WHITE);
  }

  if (dinoState == DINO_READY) {
    drawCenteredText(display, "Press UP to start", 22 + yOffset, 1);
    drawCenteredText(display, "CENTER: exit", 32 + yOffset, 1);
  } else {
    char buf[8];
    sprintf(buf, "%05d", dinoScore);
    display.setCursor(97, 15 + yOffset);
    display.print(buf);
  }

  if (dinoState == DINO_PAUSED) {
    display.fillRect(10, 16 + yOffset, 108, 44, SSD1306_BLACK);
    display.drawRect(10, 16 + yOffset, 108, 44, SSD1306_WHITE);
    drawCenteredText(display, "Game Paused", 21 + yOffset, 1);
    drawBoxedCenteredText(display, "RESUME", 16, 36 + yOffset, 44, 16, (dinoCursor == 0));
    drawBoxedCenteredText(display, "EXIT", 68, 36 + yOffset, 44, 16, (dinoCursor == 1));
  }
}

#ifndef RESTWISE_NO_RADIO
/* ---------------------------- Terminal Discord ---------------------------- */
const int DC_MAX_CONTACTS = 20;
const int DC_NAME_MAX = 11;                // names must be under 12 characters
const int DC_ID_MIN = 17, DC_ID_MAX = 20;  // Discord snowflake IDs are 17-20 digits
const char* const DC_CONTACTS_FILE = "/dc_contacts.txt";

struct DcContact {
  char name[DC_NAME_MAX + 1];
  char userId[DC_ID_MAX + 1];
  char dmId[DC_ID_MAX + 1];       // DM channel with the bot, filled in once first opened
  char lastMsgId[DC_ID_MAX + 1];  // newest message already stored locally
};
DcContact dcContacts[DC_MAX_CONTACTS];
int dcContactCount = 0;

int dcCursor = 0;       // list: -1 back, 0 "+ Contact", 1.. = contacts
int dcFormCursor = 0;   // add form: -1 back, 0 name, 1 id, 2 save
int dcEditField = 0;    // which field the shared keyboard is currently editing
int dcDeleteIdx = 0;
int dcDeleteCursor = 1; // 0 YES, 1 NO
String dcNewName = "", dcNewId = "";
String dcFormError = "";
unsigned long dcFormErrorAt = 0;

// One line per contact: name|userId|dmId|lastMsgId
void dcLoadContacts() {
  dcContactCount = 0;
  File f = LittleFS.open(DC_CONTACTS_FILE, "r");
  if (!f) return;
  while (f.available() && dcContactCount < DC_MAX_CONTACTS) {
    String line = f.readStringUntil('\n');
    line.trim();
    if (line.length() == 0) continue;
    String parts[4];
    int n = 0, start = 0;
    while (n < 4) {
      int bar = line.indexOf('|', start);
      if (bar < 0) { parts[n++] = line.substring(start); break; }
      parts[n++] = line.substring(start, bar);
      start = bar + 1;
    }
    if (n < 2 || parts[0].length() == 0 || parts[1].length() == 0) continue;
    DcContact &c = dcContacts[dcContactCount++];
    strlcpy(c.name, parts[0].c_str(), sizeof(c.name));
    strlcpy(c.userId, parts[1].c_str(), sizeof(c.userId));
    strlcpy(c.dmId, n > 2 ? parts[2].c_str() : "", sizeof(c.dmId));
    strlcpy(c.lastMsgId, n > 3 ? parts[3].c_str() : "", sizeof(c.lastMsgId));
  }
  f.close();
}

void dcSaveContacts() {
  File f = LittleFS.open(DC_CONTACTS_FILE, "w");
  if (!f) return;
  for (int i = 0; i < dcContactCount; i++) {
    f.printf("%s|%s|%s|%s\n", dcContacts[i].name, dcContacts[i].userId, dcContacts[i].dmId, dcContacts[i].lastMsgId);
  }
  f.close();
}

// Returns "" on success, otherwise a short message to show on the form.
String dcAddContact(const String &nameIn, const String &idIn) {
  String name = nameIn; name.trim();
  String id = idIn;     id.trim();
  if (name.length() == 0) return "Enter a name";
  if ((int)name.length() > DC_NAME_MAX) return "Name too long";
  if ((int)id.length() < DC_ID_MIN || (int)id.length() > DC_ID_MAX) return "ID: 17-20 digits";
  for (int i = 0; i < (int)id.length(); i++) if (id[i] < '0' || id[i] > '9') return "ID: digits only";
  if (dcContactCount >= DC_MAX_CONTACTS) return "Contact list full";
  for (int i = 0; i < dcContactCount; i++) {
    if (name.equalsIgnoreCase(dcContacts[i].name)) return "Name already used";
    if (id == dcContacts[i].userId) return "ID already saved";
  }
  DcContact &c = dcContacts[dcContactCount++];
  strlcpy(c.name, name.c_str(), sizeof(c.name));
  strlcpy(c.userId, id.c_str(), sizeof(c.userId));
  c.dmId[0] = 0;
  c.lastMsgId[0] = 0;
  dcSaveContacts();
  return "";
}

void dcDeleteContact(int idx) {
  if (idx < 0 || idx >= dcContactCount) return;
  LittleFS.remove(String("/dc_") + dcContacts[idx].userId + ".log"); // that contact's stored chat, if any
  for (int i = idx; i < dcContactCount - 1; i++) dcContacts[i] = dcContacts[i + 1];
  dcContactCount--;
  dcSaveContacts();
}

// The shared on-screen keyboard edits one form field at a time. IDs start in symbol mode because
// that's the layout with a 0 key.
void dcOpenKeyboard(int field) {
  dcEditField = field;
  kbInputBuffer = (field == 0) ? dcNewName : dcNewId;
  kbTextCursor = kbInputBuffer.length();
  if (field == 0 && kbInputBuffer.length() == 0) { currentKBMode = KB_UPPER; kbShiftOnce = true; } // names start capitalised
  else { currentKBMode = (field == 0) ? KB_LOWER : KB_SYMBOL; kbShiftOnce = false; }
  kbCursorRow = 0; kbCursorCol = 0;
  kbReturnScreen = SCREEN_DISCORD_ADD;
  currentScreen = SCREEN_WIFI_KEYBOARD;
}

void drawDiscordNoWifi(int yOffset) {
  drawHeader(yOffset, "Discord", false);
  display.setTextColor(SSD1306_WHITE);
  drawCenteredText(display, "WiFi is Off!", 24 + yOffset, 1);
  drawBoxedCenteredText(display, "OK", 44, 40 + yOffset, 40, 16, true);
}
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
void loop() {
  static unsigned long dbgIterPrev = 0, dbgIterMaxUs = 0, dbgLoops = 0;
  { unsigned long n = micros(); if (dbgIterPrev && n - dbgIterPrev > dbgIterMaxUs) dbgIterMaxUs = n - dbgIterPrev; dbgIterPrev = n; dbgLoops++; }

  readButtons();

  // Presses stay latched while the display is off (so the wake press can be swallowed below) and
  // during a slide animation (so they apply right after it) -- but only for BTN_PRESS_TTL_MS.
  bool activityDetected = false;
  bool canTakePresses = displayOn && !isAnimating;
  for (int i = 0; i < 5; i++) {
    buttonJustPressed[i] = canTakePresses && takeButtonPress(i);
    if (buttonStates[i] || btnLatched[i]) activityDetected = true;
  }

  // One line per accepted press (USB serial only) so a missed press can be told apart from a press
  // that never reached the sampler: edges = raw level changes, taken = presses the UI actually used.
  {
    static uint32_t seenPresses[5] = {0, 0, 0, 0, 0};
    static const char *const btnNames[5] = {"UP", "DOWN", "LEFT", "RIGHT", "CENTER"};
    for (int i = 0; i < 5; i++) {
      if (btnPresses[i] == seenPresses[i]) continue;
      seenPresses[i] = btnPresses[i];
      if (Serial) {
        Serial.printf("[BTN] %s press #%lu edges=%lu taken=%lu scr=%d anim=%d disp=%d\n", btnNames[i], (unsigned long)btnPresses[i],
                      (unsigned long)btnEdges[i], (unsigned long)btnTaken[i], (int)currentScreen, (int)isAnimating, (int)displayOn);
      }
    }
  }

  if (activityDetected) {
    lastActivityTime = millis();
    if (!displayOn) {
      display.ssd1306_command(SSD1306_DISPLAYON);
      displayOn = true;
      animOffsetY = 0;
      isAnimating = false;

      // Every wake from idle blanking checks the timetable first: if a block is
      // running (or it is night) the block screen comes up, otherwise the
      // watchface. (A wake from deep sleep does the same in setup().) A real Restwise sync still
      // finds its way back to the Restwise screen on its own the moment
      // traffic arrives (that handshake navigates there regardless of
      // currentScreen), so this doesn't drop an in-progress sync -- it just
      // stops resuming whatever screen you happened to be sitting on before.
      currentScreen = rwWakeScreen();

      for (int i = 0; i < 5; i++) { buttonJustPressed[i] = false; btnLatched[i] = false; }
    }
  }

  ecoTick();
  powerBatteryWatch();

  // Serial ownership: the Terminal app has its own protocol, so it reads Serial
  // while active. EVERY other screen hands Serial to the Restwise sync listener.
  // This matters because opening the USB port from a PC resets the chip -- it
  // reboots to the watchface, not the Restwise screen -- so the sync has to be
  // reachable from anywhere. processRestwiseSerial() jumps to the Restwise
  // screen on its own the moment a real sync handshake arrives.
  if (currentScreen == SCREEN_TERMINAL) {
    processTerminalSerial();
  } else {
    processRestwiseSerial();
  }

  // Idle blanking runs on every screen the user might be sitting on. The single
  // exception is animations -- blanking mid-slide would strand the transition
  // halfway. This gives the Lock Screen timeout its intended global effect.
  bool dinoRunning = (currentScreen == SCREEN_DINO && dinoState == DINO_PLAYING);
  bool allowBlank = powerMode != PM_ECO && !isAnimating && currentScreen != SCREEN_ANIMATOR && !dinoRunning &&
                     !RW_RADIO_BUSY();

  if (displayOn && allowBlank) {
    if (millis() - lastActivityTime > DISPLAY_TIMEOUT_MS) {
      display.ssd1306_command(SSD1306_DISPLAYOFF);
      displayOn = false;
    }
  }

  if (!displayOn && currentScreen == SCREEN_STOPWATCH && swRunning) {
      display.ssd1306_command(SSD1306_DISPLAYON);
      displayOn = true;
      lastActivityTime = millis();
  }

  // Deep sleep after DEEP_SLEEP_TIMEOUT_MS of true inactivity -- but never
  // while something active is running that a full reset would silently kill:
  // a live Stopwatch/Timer, a mid-transfer Restwise sync, an in-progress
  // slide, the Animator (a passive but deliberately continuous screen), a
  // WiFi scan/password-entry/connect/NTP-sync in flight, or a pending AI
  // reply. Otherwise WiFi is free to keep running through an ordinary
  // display-off idle blank -- only deep sleep forces it off.
  // Balanced sleeps after 90 s idle; Power never does; Eco has its own 5 s timer (ecoTick).
  bool allowDeepSleep = powerMode == PM_BALANCED && !isAnimating && currentScreen != SCREEN_ANIMATOR && !dinoRunning &&
                        !swRunning && tmMode != TM_RUNNING &&
                        rwSyncState != RWS_RECV &&
                        !RW_RADIO_BUSY();
  if (allowDeepSleep && millis() - lastActivityTime > DEEP_SLEEP_TIMEOUT_MS) {
    enterDeepSleep();
  }

  // The timer countdown must keep ticking even while the display is blanked
  // (e.g. you started it and walked back to the watchface).
  if (tmMode == TM_RUNNING) {
    unsigned long now = millis();
    unsigned long delta = now - tmLastTick;
    if (tmRemainingMillis > delta) {
      tmRemainingMillis -= delta;
      tmLastTick = now;
    } else {
      tmRemainingMillis = 0;
      tmMode = TM_RINGING;
      currentScreen = SCREEN_TIMER_ALERT;
      if (!displayOn) {
        display.ssd1306_command(SSD1306_DISPLAYON);
        displayOn = true;
      }
      lastActivityTime = millis();
    }
  }

  if (displayOn) {

    if (isAnimating) {
      unsigned long slideElapsed = millis() - animStartMs;
      if (slideElapsed >= SLIDE_MS) {
        animOffsetY = 0;
        currentScreen = animNextScreen;
        isAnimating = false;
      } else {
        animOffsetY = (int)((long)animTargetY * (long)slideElapsed / (long)SLIDE_MS);
      }
    } else {

      if (currentScreen == SCREEN_WATCHFACE) {
        if (buttonJustPressed[0]) {
          if (pinSet) {
            enterPinScreen(SEC_LOCK, SCREEN_WATCHFACE);
          } else {
            startAnimation(SCREEN_MENU, -64);
          }
        }
      }
      else if (currentScreen == SCREEN_MENU) {
        if (buttonJustPressed[0]) {
          menuIndex = (menuIndex - 1 + menuCount) % menuCount;
        }
        if (buttonJustPressed[1]) {
          menuIndex = (menuIndex + 1) % menuCount;
        }
        if (buttonJustPressed[4]) {
          int app = menuApps[menuIndex];
          if (app == APP_RESTWISE) {
            rwCursor = -1;
            startAnimation(SCREEN_RESTWISE, -64);
          } else if (app == APP_STOPWATCH) {
            swFocus = 1;
            startAnimation(SCREEN_STOPWATCH, -64);
          } else if (app == APP_TIMER) {
            tmMode = TM_SETTING;
            tmFocus = 1;
            startAnimation(SCREEN_TIMER, -64);
          } else if (app == APP_CALCULATOR) {
            calcCursorRow = 0; calcCursorCol = 0;
            calcInput1 = ""; calcInput2 = ""; calcOp = ' '; calcIsOpSet = false; calcError = false;
            startAnimation(SCREEN_CALCULATOR, -64);
          } else if (app == APP_ANIMATOR) {
            animatorSceneIndex = 0;
            animatorSceneStart = millis();
            startAnimation(SCREEN_ANIMATOR, -64);
          } else if (app == APP_BATTERY) {
            battCursor = -1;
            startAnimation(SCREEN_BATTERY, -64);
          } else if (app == APP_POWER) {
            powerMenuCursor = 0;
            startAnimation(SCREEN_POWER_MENU, -64);
#ifndef RESTWISE_NO_RADIO
          } else if (app == APP_WIFI) {
            if (WiFi.status() == WL_CONNECTED) {
              wifiHomeCursor = 0;
              startAnimation(SCREEN_WIFI_HOME, -64);
            } else if (wifiEnabled) {
              WiFi.scanDelete(); WiFi.disconnect();
              delay(100);
              WiFi.scanNetworks(true, false, false, 250);
              wifiScanStart = millis();
              wifiScanResults = -1;
              startAnimation(SCREEN_WIFI_SCANNING, -64);
            } else {
              wifiConfirmCursor = 0;
              startAnimation(SCREEN_WIFI_CONFIRM, -64);
            }
          } else if (app == APP_AI) {
            // Stricter than AIO_Transmitter's own gate (WiFi-connected only) --
            // this one requires real internet reachability too, not just AP
            // association, per explicit request.
            if (WiFi.status() == WL_CONNECTED && internetOK) {
              aiFocus = 1; aiScrollMode = false;
              startAnimation(SCREEN_AI_CHAT, -64);
            } else {
              startAnimation(SCREEN_AI_NOWIFI, -64);
            }
          } else if (app == APP_DISCORD) {
            if (WiFi.status() == WL_CONNECTED && internetOK) {
              dcGatewayRequest();
              dcLoadContacts();
              dcCursor = 0;
              startAnimation(SCREEN_DISCORD_LIST, -64);
            } else {
              startAnimation(SCREEN_DISCORD_NOWIFI, -64);
            }
#endif  // RESTWISE_NO_RADIO
          } else if (app == APP_DINO) {
            dinoOpen();
            startAnimation(SCREEN_DINO, -64);
          } else if (app == APP_SECURITY) {
            if (pinSet) {
              pendingAction = ACT_OPEN_MENU;
              enterPinScreen(SEC_VERIFY, SCREEN_MENU);
            } else {
              confirmType = CONF_ENABLE;
              confirmSelection = 0;
              startAnimation(SCREEN_SECURITY_CONFIRM, -64);
            }
          } else if (app == APP_LOCKSCREEN) {
            lockSettingsCursor = -1;
            for (int i = 0; i < 4; i++) if (lockTimeoutOptions[i] == displayTimeoutSec) lockSettingsCursor = i;
            if (lockSettingsCursor == -1) lockSettingsCursor = 0;
            startAnimation(SCREEN_LOCK_SETTINGS, -64);
          } else if (app == APP_TERMINAL) {
            termState = TERM_IDLE;
            termLineBuf = "";
            startAnimation(SCREEN_TERMINAL, -64);
          } else if (app == APP_LOCK) {
            startAnimation(SCREEN_WATCHFACE, 64);
          }
        }
      }
      else if (currentScreen == SCREEN_BATTERY) {
        if (buttonJustPressed[0]) { if (battCursor > -1) battCursor--; }
        if (buttonJustPressed[1]) { if (battCursor < 0) battCursor++; }
        if (buttonJustPressed[4]) {
          if (battCursor == -1) {
            startAnimation(SCREEN_MENU, 64);
          } else {
            battIndCursor = -1;
            startAnimation(SCREEN_BATTERY_INDICATOR, -64);
          }
        }
      }
      else if (currentScreen == SCREEN_BATTERY_INDICATOR) {
        if (buttonJustPressed[0]) battIndCursor = -1;
        if (buttonJustPressed[1] && battIndCursor == -1) battIndCursor = 0;
        if (buttonJustPressed[3]) battIndCursor = 1;
        if (buttonJustPressed[2] && battIndCursor == 1) battIndCursor = 0;
        if (buttonJustPressed[4]) {
          if (battIndCursor == -1) {
            battCursor = 0;
            startAnimation(SCREEN_BATTERY, 64);
          } else {
            battShowPercent = (battIndCursor == 1);
            saveBatterySettings();
            battCursor = 0;
            startAnimation(SCREEN_BATTERY, 64);
          }
        }
      }
      else if (currentScreen == SCREEN_DINO) {
        dinoHandleButtons();
      }
      else if (currentScreen == SCREEN_POWER_MENU) {
        if (buttonJustPressed[0]) { if (powerMenuCursor > -1) powerMenuCursor--; }
        if (buttonJustPressed[1]) { if (powerMenuCursor < 2) powerMenuCursor++; }
        if (buttonJustPressed[4]) {
          if (powerMenuCursor == -1) {
            startAnimation(SCREEN_MENU, 64);
          } else {
            powerPending = POWER_TILE_MODE[powerMenuCursor];
            powerConfirmCursor = 1; // default to NO
            startAnimation(SCREEN_POWER_CONFIRM, -64);
          }
        }
      }
      else if (currentScreen == SCREEN_POWER_CONFIRM) {
        if (buttonJustPressed[2]) powerConfirmCursor = 0;
        if (buttonJustPressed[3]) powerConfirmCursor = 1;
        if (buttonJustPressed[4]) {
          if (powerConfirmCursor == 0) powerSelect(powerPending); // Eco restarts the chip and never returns here
          startAnimation(SCREEN_POWER_MENU, 64);
        }
      }
      else if (currentScreen == SCREEN_ECO_CLOCK || currentScreen == SCREEN_ECO_EXIT) {
        ecoHandleButtons();
      }
#ifndef RESTWISE_NO_RADIO
      else if (currentScreen == SCREEN_DISCORD_NOWIFI) {
        if (buttonJustPressed[2] || buttonJustPressed[4]) startAnimation(SCREEN_MENU, 64);
      }
      else if (currentScreen == SCREEN_DISCORD_LIST) {
        if (buttonJustPressed[0]) { if (dcCursor > -1) dcCursor--; }
        if (buttonJustPressed[1]) { if (dcCursor < dcContactCount) dcCursor++; }
        if (buttonJustPressed[3] && dcCursor >= 1) {
          dcDeleteIdx = dcCursor - 1;
          dcDeleteCursor = 1;
          startAnimation(SCREEN_DISCORD_DELETE, -64);
        }
        if (buttonJustPressed[4]) {
          if (dcCursor == -1) {
            startAnimation(SCREEN_MENU, 64);
          } else if (dcCursor == 0) {
            dcNewName = ""; dcNewId = ""; dcFormError = "";
            dcFormCursor = 0;
            startAnimation(SCREEN_DISCORD_ADD, -64);
          }
          else dcOpenChat(dcCursor - 1);
        }
      }
      else if (currentScreen == SCREEN_DISCORD_CHAT) {
        dcHandleButtons();
      }
      else if (currentScreen == SCREEN_DISCORD_ADD) {
        if (buttonJustPressed[0]) { if (dcFormCursor > -1) dcFormCursor--; }
        if (buttonJustPressed[1]) { if (dcFormCursor < 2) dcFormCursor++; }
        if (buttonJustPressed[4]) {
          if (dcFormCursor == -1) {
            startAnimation(SCREEN_DISCORD_LIST, 64);
          } else if (dcFormCursor <= 1) {
            dcOpenKeyboard(dcFormCursor);
          } else {
            dcFormError = dcAddContact(dcNewName, dcNewId);
            if (dcFormError.length() > 0) {
              dcFormErrorAt = millis();
            } else {
              dcCursor = dcContactCount; // land on the new tile
              startAnimation(SCREEN_DISCORD_LIST, 64);
            }
          }
        }
      }
      else if (currentScreen == SCREEN_DISCORD_DELETE) {
        if (buttonJustPressed[2]) dcDeleteCursor = 0;
        if (buttonJustPressed[3]) dcDeleteCursor = 1;
        if (buttonJustPressed[4]) {
          if (dcDeleteCursor == 0) {
            dcDeleteContact(dcDeleteIdx);
            if (dcCursor > dcContactCount) dcCursor = dcContactCount;
          }
          startAnimation(SCREEN_DISCORD_LIST, 64);
        }
      }
      else if (currentScreen == SCREEN_WIFI_CONFIRM) {
        if (buttonJustPressed[0]) wifiConfirmCursor = -1;
        if (buttonJustPressed[1] && wifiConfirmCursor == -1) wifiConfirmCursor = 0;
        if (buttonJustPressed[3]) wifiConfirmCursor = 1;
        if (buttonJustPressed[2] && wifiConfirmCursor == 1) wifiConfirmCursor = 0;
        if (buttonJustPressed[4]) {
          if (wifiConfirmCursor == 0) {
            if (WIFI_APP_ENABLED) {
              wifiEnabled = true; wifiStatusMsg = ""; wifiRetryCount = 0;
              WiFi.mode(WIFI_STA); WiFi.scanDelete();
              wifiApplyRadioSettings();
              WiFi.disconnect(); delay(100);
              WiFi.scanNetworks(true);
              wifiScanStart = millis(); wifiScanResults = -1;
              startAnimation(SCREEN_WIFI_SCANNING, -64);
            }
          } else {
            startAnimation(SCREEN_MENU, 64);
          }
        }
      }
      else if (currentScreen == SCREEN_WIFI_RESULTS) {
        if (buttonJustPressed[0]) { if (wifiListIndex > -1) wifiListIndex--; }
        if (buttonJustPressed[1]) { if (wifiListIndex < wifiScanResults - 1) wifiListIndex++; }
        if (buttonJustPressed[2]) { if (wifiListIndex == -1) wifiListIndex = 0; }
        if (buttonJustPressed[4]) {
          if (wifiListIndex == -1) { WiFi.disconnect(); startAnimation(SCREEN_MENU, 64); }
          else {
            wifiTargetSSID  = WiFi.SSID(wifiListIndex);
            wifiPassword    = findSavedPwd(wifiTargetSSID); // autofill from a previous connection
            kbInputBuffer   = wifiPassword;
            wifiStatusMsg   = "";
            wifiRetryCount  = 0;
            wifiPasswordCursor = -1;
            startAnimation(SCREEN_WIFI_PASSWORD, -64);
          }
        }
      }
      else if (currentScreen == SCREEN_WIFI_PASSWORD) {
        if (buttonJustPressed[0]) {
          if (wifiPasswordCursor == 0 || wifiPasswordCursor == 1) wifiPasswordCursor = -1;
        }
        if (buttonJustPressed[1]) { if (wifiPasswordCursor == -1) wifiPasswordCursor = 0; }
        if (buttonJustPressed[2]) { if (wifiPasswordCursor == 1) wifiPasswordCursor = 0; }
        if (buttonJustPressed[3]) { if (wifiPasswordCursor == 0) wifiPasswordCursor = 1; }
        if (buttonJustPressed[4]) {
          if (wifiPasswordCursor == -1) { WiFi.disconnect(); startAnimation(SCREEN_WIFI_RESULTS, 64); }
          else if (wifiPasswordCursor == 0) {
            kbInputBuffer = wifiPassword;
            kbShiftOnce = (kbInputBuffer.length() == 0); // only an empty field starts capitalised, never an autofilled password
            currentKBMode = kbShiftOnce ? KB_UPPER : KB_LOWER;
            kbCursorRow = 0; kbCursorCol = 0;
            kbTextCursor   = kbInputBuffer.length();
            kbScrollOffset = 0;
            kbReturnScreen = SCREEN_WIFI_PASSWORD;
            currentScreen  = SCREEN_WIFI_KEYBOARD;
          } else if (wifiPasswordCursor == 1) {
            wifiApplyRadioSettings();
            WiFi.begin(wifiTargetSSID.c_str(), wifiPassword.c_str());
            wifiConnecting = true;
            wifiConnectStartTime = millis();
            wifiStatusMsg = "Connecting...";
          }
        }

        if (wifiConnecting) {
          lastActivityTime = millis();
          if (WiFi.status() == WL_CONNECTED) {
            wifiConnecting = false; wifiRetryCount = 0;
            saveCredential(wifiTargetSSID, wifiPassword);
            lastConnectedSSID = wifiTargetSSID;
            startConnectivityPinger(); // internet-reachability icon; NTP is now manual-only (WiFi Home -> NTP Sync)
            wifiHomeCursor = 0;
            startAnimation(SCREEN_WIFI_HOME, -64);
          } else if (WiFi.status() == WL_CONNECT_FAILED) {
            wifiConnecting = false; wifiRetryCount++;
            WiFi.disconnect();
            wifiStatusMsg = (wifiRetryCount >= 5) ? "Check signal/pass" : "Failed! Wrong PW?";
          } else if (millis() - wifiConnectStartTime > 15000) {
            wifiConnecting = false; wifiRetryCount++;
            WiFi.disconnect();
            wifiStatusMsg = (wifiRetryCount >= 5) ? "Check Router dist." : "Try Again...";
          }
        }
      }
      else if (currentScreen == SCREEN_WIFI_KEYBOARD) {
        if (buttonJustPressed[0]) { if (kbCursorRow > 0) kbCursorRow--; }
        if (buttonJustPressed[1]) { if (kbCursorRow < 3) kbCursorRow++; }
        if (buttonJustPressed[2]) { kbCursorCol = (kbCursorCol > 0) ? kbCursorCol - 1 : 10; }
        if (buttonJustPressed[3]) { kbCursorCol = (kbCursorCol < 10) ? kbCursorCol + 1 : 0; }
        if (buttonJustPressed[4]) {
          const char* key;
          if (currentKBMode == KB_UPPER) key = kbUpper[kbCursorRow][kbCursorCol];
          else if (currentKBMode == KB_SYMBOL) key = kbSymbol[kbCursorRow][kbCursorCol];
          else key = kbLower[kbCursorRow][kbCursorCol];

          if (strcmp(key, "EN") == 0) {
            // Enter parks the text in the input box and puts the cursor on
            // SEND for AI Chat (so posting it is one more press, not
            // accidental), vs. committing straight into the password field.
            if (kbReturnScreen == SCREEN_AI_CHAT) {
              aiInputText = kbInputBuffer;
              aiFocus = (aiInputText.length() > 0) ? 2 : 1;
            } else if (kbReturnScreen == SCREEN_DISCORD_CHAT) {
              dcInputText = kbInputBuffer;
              dcFocus = (dcInputText.length() > 0) ? 2 : 1;
            } else if (kbReturnScreen == SCREEN_DISCORD_ADD) {
              if (dcEditField == 0) dcNewName = kbInputBuffer;
              else dcNewId = kbInputBuffer;
              dcFormCursor = (dcEditField == 0) ? 1 : 2; // move on to the next field / SAVE
            } else {
              wifiPassword = kbInputBuffer;
            }
            currentScreen = kbReturnScreen;
          } else if (strcmp(key, "CL") == 0) {
            if (kbTextCursor > 0) kbTextCursor--;
          } else if (strcmp(key, "CR") == 0) {
            if (kbTextCursor < (int)kbInputBuffer.length()) kbTextCursor++;
          } else if (strcmp(key, "<") == 0 && currentKBMode != KB_SYMBOL) {
            if (kbTextCursor > 0) kbTextCursor--;
          } else if (strcmp(key, ">") == 0 && currentKBMode != KB_SYMBOL) {
            if (kbTextCursor < (int)kbInputBuffer.length()) kbTextCursor++;
          } else if (strcmp(key, "BS") == 0) {
            if (kbTextCursor > 0 && kbInputBuffer.length() > 0) {
              kbInputBuffer.remove(kbTextCursor - 1, 1);
              kbTextCursor--;
            }
          } else if (strcmp(key, "^") == 0) {
            if (kbShiftOnce && currentKBMode == KB_UPPER) {
              currentKBMode = KB_LOWER; // ^ on the automatic first capital means "no, lowercase"
            } else {
              if (currentKBMode == KB_LOWER) currentKBMode = KB_UPPER;
              else if (currentKBMode == KB_UPPER) currentKBMode = KB_SYMBOL;
              else currentKBMode = KB_LOWER;
            }
            kbShiftOnce = false;
          } else {
            bool allow = true;
            if (kbReturnScreen == SCREEN_DISCORD_CHAT) {
              allow = (int)kbInputBuffer.length() < DC_SEND_MAX;
            } else if (kbReturnScreen == SCREEN_DISCORD_ADD) {
              if (dcEditField == 0) allow = ((int)kbInputBuffer.length() < DC_NAME_MAX) && key[0] != '|' && key[0] != '\\';
              else allow = ((int)kbInputBuffer.length() < DC_ID_MAX) && key[0] >= '0' && key[0] <= '9';
            }
            if (allow) {
              kbInputBuffer = kbInputBuffer.substring(0, kbTextCursor) + String(key) + kbInputBuffer.substring(kbTextCursor);
              kbTextCursor += String(key).length();
              if (kbShiftOnce) { // the automatic first capital is used up
                if (currentKBMode == KB_UPPER) currentKBMode = KB_LOWER;
                kbShiftOnce = false;
              }
            }
          }
        }
      }
      else if (currentScreen == SCREEN_WIFI_HOME) {
        if (buttonJustPressed[0]) { if (wifiHomeCursor > -1) wifiHomeCursor--; }
        if (buttonJustPressed[1]) { if (wifiHomeCursor < 2) wifiHomeCursor++; }
        if (buttonJustPressed[2]) { if (wifiHomeCursor == -1) wifiHomeCursor = 0; }
        if (buttonJustPressed[4]) {
          if (wifiHomeCursor == -1) startAnimation(SCREEN_MENU, 64);
          else if (wifiHomeCursor == 0) { wifiToggleCursor = 1; startAnimation(SCREEN_WIFI_TOGGLE_CONFIRM, -64); }
          else if (wifiHomeCursor == 1) {
            wifiForgetTargetSSID = WiFi.SSID();
            wifiForgetCursor = 1;
            startAnimation(SCREEN_WIFI_FORGET_CONFIRM, -64);
          }
          else if (wifiHomeCursor == 2) {
            startNtpSync();
            startAnimation(SCREEN_WIFI_NTP, -64);
          }
        }
      }
      else if (currentScreen == SCREEN_WIFI_TOGGLE_CONFIRM) {
        if (buttonJustPressed[2]) wifiToggleCursor = 0;
        if (buttonJustPressed[3]) wifiToggleCursor = 1;
        if (buttonJustPressed[4]) {
          if (wifiToggleCursor == 0) {
            wifiEnabled = false;
            WiFi.disconnect(true);
            WiFi.mode(WIFI_OFF);
            startAnimation(SCREEN_MENU, 64);
          } else {
            startAnimation(SCREEN_WIFI_HOME, 64);
          }
        }
      }
      else if (currentScreen == SCREEN_WIFI_FORGET_CONFIRM) {
        if (buttonJustPressed[2]) wifiForgetCursor = 0;
        if (buttonJustPressed[3]) wifiForgetCursor = 1;
        if (buttonJustPressed[4]) {
          if (wifiForgetCursor == 0) {
            forgetCredential(wifiForgetTargetSSID);
            if (lastConnectedSSID == wifiForgetTargetSSID) lastConnectedSSID = "";
            WiFi.disconnect();
            startAnimation(SCREEN_MENU, 64);
          } else {
            startAnimation(SCREEN_WIFI_HOME, 64);
          }
        }
      }
      else if (currentScreen == SCREEN_AI_NOWIFI) {
        if (buttonJustPressed[2] || buttonJustPressed[4]) startAnimation(SCREEN_MENU, 64);
      }
      else if (currentScreen == SCREEN_AI_CHAT) {
        // Scroll mode swallows Up/Down for the transcript; center hands control back.
        if (aiScrollMode) {
          if (buttonJustPressed[0]) aiScroll -= AI_LINE_H;
          if (buttonJustPressed[1]) aiScroll += AI_LINE_H;
          if (aiScroll < 0) aiScroll = 0; // lower clamp needs render height, drawAiChat does it
          if (buttonJustPressed[4]) aiScrollMode = false;
        } else {
          if (buttonJustPressed[0]) { if (aiFocus > -1) aiFocus--; }
          if (buttonJustPressed[1]) { if (aiFocus <  2) aiFocus++; }
          // Input and SEND sit side by side, so Left/Right moves between them.
          if (buttonJustPressed[2]) { if (aiFocus == 2) aiFocus = 1; else if (aiFocus == 1) aiFocus = -1; }
          if (buttonJustPressed[3]) { if (aiFocus == 1) aiFocus = 2; }

          if (buttonJustPressed[4]) {
            if (aiFocus == -1) {
              startAnimation(SCREEN_MENU, 64);
            } else if (aiFocus == 0) {
              aiScrollMode = true;
            } else if (aiFocus == 1) {
              kbInputBuffer  = aiInputText;
              kbTextCursor   = kbInputBuffer.length();
              kbScrollOffset = 0;
              currentKBMode  = KB_LOWER;
              kbShiftOnce = false;
              kbCursorRow = 0; kbCursorCol = 0;
              kbReturnScreen = SCREEN_AI_CHAT;
              currentScreen  = SCREEN_WIFI_KEYBOARD;
            } else if (aiFocus == 2) {
              aiSendMessage();
            }
          }
        }
      }
#endif  // RESTWISE_NO_RADIO
      else if (currentScreen == SCREEN_ANIMATOR) {
        // Passive playback screen -- the back box is always focused, CENTER exits.
        if (buttonJustPressed[4]) {
          startAnimation(SCREEN_MENU, 64);
        }
        if (buttonJustPressed[3] && animatorFps < 60) animatorFps += 10;
        if (buttonJustPressed[2] && animatorFps > 10) animatorFps -= 10;
      }
      else if (currentScreen == SCREEN_STOPWATCH) {

        if (buttonJustPressed[0]) {
          if (swFocus == 1 || swFocus == 2) swFocus = 0;
        }
        if (buttonJustPressed[1]) {
          if (swFocus == 0) swFocus = 1;
        }
        if (buttonJustPressed[2]) {
          if (swFocus == 2) swFocus = 1;
        }
        if (buttonJustPressed[3]) {
          if (swFocus == 1) swFocus = 2;
        }

        if (buttonJustPressed[4]) {
          if (swFocus == 0) {
            startAnimation(SCREEN_MENU, 64);
          } else if (swFocus == 1) {
            if (swRunning) {
              swElapsedTime += millis() - swStartTime;
              swRunning = false;
            } else {
              swStartTime = millis();
              swRunning = true;
            }
          } else if (swFocus == 2) {
            if (swRunning) {
              swElapsedTime += millis() - swStartTime;
              swRunning = false;
            } else {
              swElapsedTime = 0;
            }
          }
        }
      }
      else if (currentScreen == SCREEN_TIMER) {

        if (buttonJustPressed[0]) {
          if (tmFocus > 0) tmFocus = 0;
        }
        if (buttonJustPressed[1]) {
          if (tmFocus == 0) tmFocus = 1;
        }
        if (buttonJustPressed[2]) {
          if (tmMode == TM_SETTING) {
            if (tmFocus == 2) tmFocus = 1;
            else if (tmFocus == 3) tmFocus = 2;
            else if (tmFocus == 1) tmFocus = 0;
          } else if (tmMode == TM_READY) {
            if (tmFocus == 3) tmFocus = 1;
            else if (tmFocus == 1) tmFocus = 0;
          }
        }
        if (buttonJustPressed[3]) {
          if (tmMode == TM_SETTING) {
            if (tmFocus == 1) tmFocus = 2;
            else if (tmFocus == 2) tmFocus = 3;
          } else if (tmMode == TM_READY) {
            if (tmFocus == 1) tmFocus = 3;
          }
        }

        if (buttonStates[4] && tmFocus == 2 && tmMode == TM_SETTING) {
          if (tmSetPressStart == 0) tmSetPressStart = millis();
          if (millis() - tmSetPressStart > 2000 && !tmLongPressTriggered) {
            tmMode = TM_READY;
            tmFocus = 3;
            tmLongPressTriggered = true;
          }
        } else {
          tmSetPressStart = 0;
          tmLongPressTriggered = false;
        }

        if (buttonJustPressed[4]) {
          if (tmFocus == 0) {
            startAnimation(SCREEN_MENU, 64);
          }
          else if (tmMode == TM_SETTING) {
            if (tmFocus == 1) {
              if (tmActiveUnit == 0) tmHours = (tmHours + 1) % 24;
              else if (tmActiveUnit == 1) tmMinutes = (tmMinutes + 1) % 60;
              else if (tmActiveUnit == 2) tmSeconds = (tmSeconds + 1) % 60;
            } else if (tmFocus == 2) {
              tmActiveUnit = (tmActiveUnit + 1) % 3;
            } else if (tmFocus == 3) {
              if (tmActiveUnit == 0) tmHours = (tmHours + 23) % 24;
              else if (tmActiveUnit == 1) tmMinutes = (tmMinutes + 59) % 60;
              else if (tmActiveUnit == 2) tmSeconds = (tmSeconds + 59) % 60;
            }
          }
          else if (tmMode == TM_READY) {
            if (tmFocus == 1) tmMode = TM_SETTING;
            else if (tmFocus == 3) {
              tmRemainingMillis = ((unsigned long)tmHours * 3600 + tmMinutes * 60 + tmSeconds) * 1000;
              if (tmRemainingMillis > 0) {
                tmMode = TM_RUNNING;
                tmLastTick = millis();
              }
            }
          }
          else if (tmMode == TM_RUNNING) {
            if (tmFocus == 1) tmMode = TM_READY;
            else if (tmFocus == 3) {

            }
          }
        }
      }
      else if (currentScreen == SCREEN_TIMER_ALERT) {
        if (buttonJustPressed[0] || buttonJustPressed[1] || buttonJustPressed[2] ||
            buttonJustPressed[3] || buttonJustPressed[4]) {
          tmMode = TM_SETTING;
          startAnimation(SCREEN_WATCHFACE, 64);
        }
      }
      else if (currentScreen == SCREEN_CALCULATOR) {
        // Navigation: 5 rows x 4 cols, wrap around
        if (buttonJustPressed[0]) calcCursorRow = (calcCursorRow > 0) ? calcCursorRow - 1 : 4;
        if (buttonJustPressed[1]) calcCursorRow = (calcCursorRow < 4) ? calcCursorRow + 1 : 0;
        if (buttonJustPressed[2]) {
          calcCursorCol--;
          if (calcCursorCol < 0) calcCursorCol = 3;
        }
        if (buttonJustPressed[3]) {
          calcCursorCol++;
          if (calcCursorCol > 3) calcCursorCol = 0;
        }

        if (buttonJustPressed[4]) {
          const char* key = calcGrid[calcCursorRow][calcCursorCol];
          String keyStr = String(key);

          if (keyStr == "<--") {
            calcInput1 = ""; calcInput2 = ""; calcOp = ' '; calcIsOpSet = false; calcError = false;
            startAnimation(SCREEN_MENU, 64);

          } else if (keyStr == "C") {
            calcInput1 = ""; calcInput2 = ""; calcOp = ' '; calcIsOpSet = false; calcError = false;

          } else if (keyStr == "DEL") {
            if (calcError) { calcInput1 = ""; calcInput2 = ""; calcOp = ' '; calcIsOpSet = false; calcError = false; }
            else if (calcIsOpSet) {
              if (calcInput2.length() > 0) calcInput2.remove(calcInput2.length() - 1);
              else { calcIsOpSet = false; calcOp = ' '; }
            } else {
              if (calcInput1.length() > 0) calcInput1.remove(calcInput1.length() - 1);
            }

          } else if (keyStr == "=") {
            if (!calcError && calcIsOpSet && calcInput2.length() > 0) {
              float v1 = calcInput1.toFloat(), v2 = calcInput2.toFloat(), res = 0;
              bool dz = false;
              if (calcOp=='+') res=v1+v2;
              else if (calcOp=='-') res=v1-v2;
              else if (calcOp=='*') res=v1*v2;
              else if (calcOp=='/') { if (v2!=0) res=v1/v2; else dz=true; }
              if (dz) { calcError = true; }
              else {
                calcInput1 = String(res, 4);
                while (calcInput1.endsWith("0") && calcInput1.indexOf(".")!=-1) calcInput1.remove(calcInput1.length()-1);
                if (calcInput1.endsWith(".")) calcInput1.remove(calcInput1.length()-1);
                calcInput2 = ""; calcOp = ' '; calcIsOpSet = false;
              }
            }

          } else if (keyStr=="+" || keyStr=="-" || keyStr=="*" || keyStr=="/") {
            char op = key[0];
            if (!calcError && calcInput1.length() > 0) {
              if (calcIsOpSet && calcInput2.length() > 0) {
                float v1=calcInput1.toFloat(), v2=calcInput2.toFloat(), res=0;
                bool dz=false;
                if (calcOp=='+') res=v1+v2;
                else if (calcOp=='-') res=v1-v2;
                else if (calcOp=='*') res=v1*v2;
                else if (calcOp=='/') { if (v2!=0) res=v1/v2; else dz=true; }
                if (dz) { calcError=true; }
                else {
                  calcInput1=String(res,4);
                  while(calcInput1.endsWith("0")&&calcInput1.indexOf(".")!=-1) calcInput1.remove(calcInput1.length()-1);
                  if(calcInput1.endsWith(".")) calcInput1.remove(calcInput1.length()-1);
                  calcInput2=""; calcOp=op; calcIsOpSet=true;
                }
              } else { calcOp=op; calcIsOpSet=true; }
            }

          } else if (keyStr == "SCI") {
            calcSciRow = 0; calcSciCol = 0;
            startAnimation(SCREEN_CALCULATOR_SCI, -64);

          } else if (keyStr != "") {
            // digit or .
            if (calcError) { calcInput1=""; calcInput2=""; calcOp=' '; calcIsOpSet=false; calcError=false; }
            if (calcIsOpSet) {
              if (keyStr=="." && calcInput2.indexOf(".")!=-1) {}
              else if (calcInput2.length()<10) calcInput2 += keyStr;
            } else {
              if (keyStr=="." && calcInput1.indexOf(".")!=-1) {}
              else if (calcInput1.length()<10) calcInput1 += keyStr;
            }
          }
        }
      }

      else if (currentScreen == SCREEN_CALCULATOR_SCI) {
        if (buttonJustPressed[0]) calcSciRow = (calcSciRow > 0) ? calcSciRow - 1 : 2;
        if (buttonJustPressed[1]) calcSciRow = (calcSciRow < 2) ? calcSciRow + 1 : 0;
        if (buttonJustPressed[2]) calcSciCol = (calcSciCol > 0) ? calcSciCol - 1 : 1;
        if (buttonJustPressed[3]) calcSciCol = (calcSciCol < 1) ? calcSciCol + 1 : 0;

        if (buttonJustPressed[4]) {
          const char* key = sciGrid[calcSciRow][calcSciCol];

          // BACK just goes back; every other key applies a function first.
          if (strcmp(key, "BACK") != 0) {
            String* activeInput = calcIsOpSet ? &calcInput2 : &calcInput1;
            float v = activeInput->toFloat();
            bool hasVal = (activeInput->length() > 0 && !calcError);
            String result = "";
            bool sciError = false;

            if (strcmp(key, "x^2") == 0) {
              if (hasVal) result = String(v * v, 4);
            } else if (strcmp(key, "sqrt") == 0) {
              if (hasVal && v >= 0) result = String(sqrt(v), 4);
              else sciError = true;
            } else if (strcmp(key, "pi") == 0) {
              result = "3.14159265";
            } else if (strcmp(key, "x^3") == 0) {
              if (hasVal) result = String(v * v * v, 4);
            } else if (strcmp(key, "cbrt") == 0) {
              if (hasVal) {
                float cb = (v >= 0) ? pow(v, 1.0f/3.0f) : -pow(-v, 1.0f/3.0f);
                result = String(cb, 4);
              }
            }

            if (sciError) {
              calcError = true;
            } else if (result.length() > 0) {
              // Trim trailing zeros
              while (result.endsWith("0") && result.indexOf(".") != -1) result.remove(result.length()-1);
              if (result.endsWith(".")) result.remove(result.length()-1);
              if (strcmp(key, "pi") == 0) {
                if (!calcIsOpSet) calcInput1 = result;
                else calcInput2 = result;
              } else {
                *activeInput = result;
              }
            }
          }
          startAnimation(SCREEN_CALCULATOR, 64);
        }
      }

      else if (currentScreen == SCREEN_PIN_ENTRY) {
        if (buttonJustPressed[0]) pinCursorRow = (pinCursorRow > 0) ? pinCursorRow - 1 : 3;
        if (buttonJustPressed[1]) pinCursorRow = (pinCursorRow < 3) ? pinCursorRow + 1 : 0;
        if (buttonJustPressed[2]) pinCursorCol = (pinCursorCol > 0) ? pinCursorCol - 1 : 2;
        if (buttonJustPressed[3]) pinCursorCol = (pinCursorCol < 2) ? pinCursorCol + 1 : 0;

        if (buttonJustPressed[4]) {
          const char* key = pinKeys[pinCursorRow][pinCursorCol];
          if (strcmp(key, "<") == 0) {
            if (pinBuffer.length() > 0) {
              pinBuffer.remove(pinBuffer.length() - 1);
            } else {
              pinBuffer = ""; pinPendingNew = ""; pinErrorMsg = "";
              securityFlow = SEC_NONE;
              pendingAction = ACT_NONE;
              startAnimation(pinReturnScreen, 64);
            }
          } else if (strcmp(key, "OK") == 0) {
            if (pinBuffer.length() == 4) handlePinSubmit();
          } else {
            if (pinBuffer.length() < 4) {
              pinBuffer += key;
              if (pinBuffer.length() == 4) handlePinSubmit();
            }
          }
        }
      }
      else if (currentScreen == SCREEN_SECURITY_MENU) {
        if (buttonJustPressed[0]) {
          secMenuCursor = (secMenuCursor > -1) ? secMenuCursor - 1 : 1;
        }
        if (buttonJustPressed[1]) {
          secMenuCursor = (secMenuCursor < 1) ? secMenuCursor + 1 : -1;
        }
        if (buttonJustPressed[4]) {
          if (secMenuCursor == -1) {
            startAnimation(SCREEN_MENU, 64);
          } else if (secMenuCursor == 0) {
            pendingAction = ACT_CHANGE;
            enterPinScreen(SEC_VERIFY, SCREEN_SECURITY_MENU);
          } else if (secMenuCursor == 1) {
            pendingAction = ACT_DISABLE;
            enterPinScreen(SEC_VERIFY, SCREEN_SECURITY_MENU);
          }
        }
      }
      else if (currentScreen == SCREEN_SECURITY_CONFIRM) {
        if (buttonJustPressed[2]) confirmSelection = 0;
        if (buttonJustPressed[3]) confirmSelection = 1;
        if (buttonJustPressed[4]) {
          bool yes = (confirmSelection == 0);
          if (confirmType == CONF_ENABLE) {
            if (yes) {
              pinReturnScreen = SCREEN_MENU;
              pendingAction = ACT_OPEN_MENU;
              pinBuffer = ""; pinPendingNew = ""; pinErrorMsg = "";
              pinCursorRow = 0; pinCursorCol = 1;
              securityFlow = SEC_SET_NEW;
              startAnimation(SCREEN_PIN_ENTRY, -64);
            } else {
              confirmType = CONF_NONE;
              startAnimation(SCREEN_MENU, 64);
            }
          } else if (confirmType == CONF_DISABLE) {
            if (yes) {
              pinSet = false;
              pinStored = "";
              saveSettings();
              confirmType = CONF_NONE;
              pendingAction = ACT_NONE;
              startAnimation(SCREEN_MENU, 64);
            } else {
              confirmType = CONF_NONE;
              startAnimation(SCREEN_SECURITY_MENU, 64);
            }
          }
        }
      }
      else if (currentScreen == SCREEN_LOCK_SETTINGS) {
        if (buttonJustPressed[0]) {
          lockSettingsCursor = (lockSettingsCursor > -1) ? lockSettingsCursor - 1 : 3;
        }
        if (buttonJustPressed[1]) {
          lockSettingsCursor = (lockSettingsCursor < 3) ? lockSettingsCursor + 1 : -1;
        }
        if (buttonJustPressed[4]) {
          if (lockSettingsCursor == -1) {
            startAnimation(SCREEN_MENU, 64);
          } else {
            int chosen = lockTimeoutOptions[lockSettingsCursor];
            if (chosen != displayTimeoutSec) {
              displayTimeoutSec = chosen;
              DISPLAY_TIMEOUT_MS = (unsigned long)displayTimeoutSec * 1000UL;
              saveSettings();
            }
          }
        }
      }
      else if (currentScreen == SCREEN_TERMINAL) {
        if (termState == TERM_IDLE) {
          if (buttonJustPressed[4]) {
            startAnimation(SCREEN_MENU, 64);
          }
        } else if (termState == TERM_CONFIRM) {
          if (buttonJustPressed[2]) termConfirmSelection = 0; // LEFT  -> Yes
          if (buttonJustPressed[3]) termConfirmSelection = 1; // RIGHT -> No
          if (buttonJustPressed[4]) {
            applyTerminalCommand(termConfirmSelection == 0);
            termState = TERM_IDLE;
          }
        }
      }
      else if (currentScreen == SCREEN_RESTWISE) {
        // Focus moves over the back arrow (-1) and the 7 day items (0..6).
        // The day list only exists once a timetable has been synced; with no
        // data the only thing to focus is the back arrow.
        if (rwHasData) {
          if (buttonJustPressed[0]) rwCursor = (rwCursor > -1) ? rwCursor - 1 : 6;
          if (buttonJustPressed[1]) rwCursor = (rwCursor < 6) ? rwCursor + 1 : -1;
        } else {
          rwCursor = -1;
        }
        if (buttonJustPressed[4]) {
          if (rwCursor == -1) {
            startAnimation(SCREEN_MENU, 64);
          } else if (rwHasData) {
            rwSelectedDayItem = rwCursor;
            rwDayScroll = 0;
            startAnimation(SCREEN_RESTWISE_DAY, -64);
          }
        }
      }
      else if (currentScreen == SCREEN_RESTWISE_DAY) {
        // Passive scroll only -- rows aren't focusable. LEFT is the sole way back.
        int *idx = rwDayIdx;
        int n = rwBuildDayList(rwResolveDayIndex(rwSelectedDayItem), idx, RW_DAY_MAX);
        int maxScroll = (n > RW_DAY_ROWS) ? (n - RW_DAY_ROWS) : 0;
        if (buttonJustPressed[0] && rwDayScroll > 0) rwDayScroll--;
        if (buttonJustPressed[1] && rwDayScroll < maxScroll) rwDayScroll++;
        if (buttonJustPressed[2]) startAnimation(SCREEN_RESTWISE, 64);
      }
      else if (currentScreen == SCREEN_BLOCK) {
        // The block that is running now (or the bedtime greeting) -- UP scrolls up to the watchface.
        if (buttonJustPressed[0]) startAnimation(SCREEN_WATCHFACE, -64);
      }
    }

    if (currentScreen == SCREEN_DINO && !isAnimating) dinoTick();

    if (pinErrorMsg.length() > 0 && millis() - pinErrorShownAt > 1500) pinErrorMsg = "";

    static unsigned long lastStatusUpdate = 0;
    if (millis() - lastStatusUpdate > 100) {
      statusIndex++;
      lastStatusUpdate = millis();
    }

    // Frames are paced to an exact 60 FPS (16666us). The deadline advances by one period each
    // frame instead of being reset to "now", so slow or late frames don't accumulate drift and
    // the average rate is exactly 60. Button reads and animation stepping above still run every
    // loop tick -- only the full-frame display.display() transfer is paced.
    static uint32_t nextFrameUs = 0;
    // The Animator lets the user pick its own rate. Animation is time-based, so a lower FPS
    // plays at the same speed, just choppier.
    uint32_t frameUs = 1000000UL / 60;
    if (currentScreen == SCREEN_ANIMATOR && !isAnimating) frameUs = 1000000UL / animatorFps;
    if (powerMode == PM_ECO) frameUs = 1000000UL / 5; // Eco: 5 FPS
    uint32_t nowUs = micros();
    int32_t lateUs = (int32_t)(nowUs - nextFrameUs);
    // nextFrameUs only advances while the display is on, and micros() wraps every ~71.6 minutes. After a
    // long blank the deadline can look like it is far in the *future* (negative lateUs), which would
    // suppress every frame for up to ~36 minutes. A real deadline is never more than one period ahead.
    if (lateUs < -1000000) { nextFrameUs = nowUs; lateUs = 0; }
    if (lateUs >= 0) {
      if (lateUs > (int32_t)(2 * frameUs)) nextFrameUs = nowUs; // long stall: resync instead of bursting frames
      nextFrameUs += frameUs;
      updateDisplay();
      dbgFrames++;
    }
  }

#ifndef RESTWISE_NO_RADIO
  // ---- WiFi scan polling (async scanNetworks(), same pattern as AIO_Transmitter) ----
  if (currentScreen == SCREEN_WIFI_SCANNING && !isAnimating) {
    lastActivityTime = millis();
    int result = WiFi.scanComplete();
    static bool scanRetried = false;
    if (result >= 0) {
      wifiScanResults = result;
      wifiListIndex = 0; wifiListScroll = 0;
      startAnimation(SCREEN_WIFI_RESULTS, -64);
      scanRetried = false;
    } else if (result == WIFI_SCAN_FAILED) {
      if (!scanRetried) {
        scanRetried = true;
        WiFi.scanNetworks(true, false, false, 80);
      } else {
        wifiScanResults = 0;
        startAnimation(SCREEN_WIFI_RESULTS, -64);
        scanRetried = false;
      }
    } else if (millis() - wifiScanStart > 8000) {
      WiFi.scanDelete();
      wifiScanResults = 0;
      startAnimation(SCREEN_WIFI_RESULTS, -64);
      scanRetried = false;
    }
  }

  // Drain a finished AI reply on the UI thread -- the network task only ever
  // hands back a string, the transcript itself is written from here alone.
  if (aiReplyReady) {
    aiReplyReady = false;
    aiBusy       = false;
    aiAppendMsg(false, aiReplyText.length() ? aiReplyText : String("[No reply]"));
    aiReplyText  = "";
    lastActivityTime = millis(); // a reply counts as activity, don't sleep on it
  }

  // Bring the Discord gateway up the moment WiFi and internet are both there, wherever you are on the
  // watch. Status then follows where you are: green inside the Discord app, idle (yellow moon) outside.
  if (WIFI_APP_ENABLED && !dcGwWanted && WiFi.status() == WL_CONNECTED && internetOK) dcGatewayRequest();

  dcUpdate();

  // ---- NTP sync polling -- non-blocking. The 4 query tasks run independently
  // in the background; this just checks in on them each loop tick. Waits for
  // either all 4 to finish or the 20s budget to expire, then picks the
  // highest-priority (lowest index) server among whichever succeeded -- this
  // is what makes "if more than one returns, higher priority wins" correct,
  // rather than just racing to whichever task happens to finish first. ----
  if (currentScreen == SCREEN_WIFI_NTP && !isAnimating) {
    lastActivityTime = millis();
    if (wifiNtpState == 0) {
      bool allDone = ntpSlotDone[0] && ntpSlotDone[1] && ntpSlotDone[2] && ntpSlotDone[3];
      bool timedOut = millis() - wifiNtpStart > NTP_TIMEOUT_MS;
      if (allDone || timedOut) {
        int best = -1;
        for (int i = 0; i < NUM_NTP_SERVERS; i++) {
          if (ntpSlotOk[i]) { best = i; break; } // index 0 = highest priority
        }
        wifiNtpBestServer = best;
        if (best >= 0) {
          time_t t = (time_t)(ntpSlotEpoch[best] + NTP_GMT_OFFSET_SEC);
          struct tm ti;
          gmtime_r(&t, &ti);
          DateTime ntpTime(ti.tm_year + 1900, ti.tm_mon + 1, ti.tm_mday, ti.tm_hour, ti.tm_min, ti.tm_sec);
          setDeviceTime(ntpTime);
          char buf[32];
          sprintf(buf, "Synced to %02d:%02d", ti.tm_hour, ti.tm_min);
          wifiNtpResultMsg = String(buf);
          wifiNtpState = 1;
        } else {
          wifiNtpResultMsg = "Failed: Timeout Error";
          wifiNtpState = 2;
        }
        wifiNtpDoneAt = millis();
      }
    } else if (millis() - wifiNtpDoneAt > NTP_RESULT_HOLD_MS) {
      startAnimation(SCREEN_WIFI_HOME, 64);
    }
  }
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
