periashutosh-prog/Restwise-Watch/discord_config.example.h

// -----------------------------------------------------------------------------
// Template for discord_config.h -- copy this file to discord_config.h and fill in
// your bot token. discord_config.h is gitignored so the token never lands in the repo.
//
//   cp discord_config.example.h discord_config.h
//
// Token: Discord Developer Portal -> your application -> Bot -> Reset Token.
// (Not the "Public Key" on the General Information page -- that one only verifies
// webhooks and can't log a bot in.)
// -----------------------------------------------------------------------------
#ifndef DISCORD_CONFIG_H
#define DISCORD_CONFIG_H

#define DISCORD_BOT_TOKEN "PUT_YOUR_DISCORD_BOT_TOKEN_HERE"

#endif
