periashutosh-prog/Restwise-Watch/(commit log)

2026-09-20 Initial commit: Restwise ESP32-C6 firmware, docs, and PCB files
    Radio-off wellbeing watch firmware ported to ESP32-C6, with README,
    All Rights Reserved license, and hardware design files.
2026-09-28 Add 60 FPS display cap, dual-speed I2C, USB CDC on boot, and an Animator app
    - Cap the OLED refresh at a user-selectable FPS (10-60, LEFT/RIGHT to
    adjust) instead of redrawing uncapped every loop tick; buttons and
    animation stepping still run every tick for responsiveness.
    - Run I2C at 1MHz for the display, dropping to 400kHz (its datasheet
    max) around every DS3231 transaction.
    - Enable USB CDC On Boot (sketch.yaml default_fqbn) so the serial port
    enumerates reliably from power-on instead of only after Serial.begin().
    - Add an Animator app: an endless rainy loop with occasional lightning
    (progressively-drawn bolt, center-out whiteout), fully time-based so
    it stays smooth and repr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
2026-09-30 Add Battery app, deep sleep, and a full WiFi app with manual NTP sync
    - Battery: FreeRTOS task samples IO2 1000x/sec (calibrated mV via
    analogReadMilliVolts), averages once/sec, estimates percent from a
    piecewise-linear 1S LiPo curve, detects charging from a rolling
    8-second voltage-rise window. New menu app shows voltage/percent/ADC
    raw/charging; watchface gets a 4-segment battery icon that blinks
    while charging.
    - Deep sleep: after 90s idle (excluding active Stopwatch/Timer, a
    mid-transfer Restwise sync, the Animator, or anything mid-WiFi),
    the watch drops into true deep sleep. Only CENTER (GPIO3) can wake
    it -- the ESP32-C6's LP domain is GPIO0-7 only. Every wake, deep
    s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
2026-10-02 Add AI chatbot, manual NTP sync, Good Night rework, and Battery app v2
    Battery: scrollable screen with raw (un-averaged, 100ms) ADC/voltage,
    persisted Icon/Percentage watchface indicator with picker screen, and a
    seed sample so boot/wake never shows "--" or an empty icon. Also adds
    the Groq-backed AI chatbot (key kept in gitignored ai_config.h), parallel
    raw-SNTP NTP sync, and sleep-timetable-aware Good Night screen.
    [Restwise-watch.ino, ai_config.example.h]
2026-10-05 Fix missed/laggy button presses with a dedicated sampler task
    Measured on hardware: one screen redraw costs ~26ms and buttons were only
    read once per loop pass (every 60-70ms in the Animator), so quick taps fell
    between polls -- worst when RIGHT raised the FPS. A priority-2 task now
    samples every 5ms with a 20ms debounce and latches each press until loop()
    takes it, so presses during redraws or slide animations are kept (350ms TTL).
    [Restwise-watch.ino]
2026-10-05 Run the OLED at a real 1MHz and make screen slides time-based
    The Adafruit SSD1306 driver forces its own bus speed around every frame
    (default 400kHz, then 100kHz), silently overriding Wire.setClock(), so a
    frame push cost ~23ms. Passing the clocks to the constructor cuts a full
    redraw from ~26ms to ~13ms. Slides stepped 8px per loop pass and got twice
    as fast with it, so they now run on a fixed 250ms timer (SLIDE_MS).
    [Restwise-watch.ino]
2026-10-05 Dino: drive cacti and ground from one whole-pixel scroll counter
    Both used to round their own decimal positions independently, so they
    could step by different pixel counts in the same frame and shimmer
    against each other. Cacti now store the scroll counter at spawn and are
    drawn/collided at 128 - (counter - spawn), the same counter the ground uses.
    [Restwise-watch.ino]
2026-10-05 Pace frames to an exact 60 FPS
    A 17ms minimum between frames plus a 5ms loop delay put the real rate at
    ~55 FPS. Frames now run against an advancing microsecond deadline
    (16666us) and the loop delay is 1ms. Measured on hardware: 60.0 FPS with
    ~13.7ms per redraw, ~3ms headroom.
2026-10-05 Set the WiFi hostname to Ashutosh-Smartwatch
    WiFi.setHostname() only stores the name in this core and it is applied
    whenever the STA interface starts, so one call at boot (before any
    WiFi.mode()/begin()) covers every connect without powering the radio.
    Kept to letters/digits/hyphens since hostnames can't contain apostrophes.
2026-10-07 Add Discord app, Power Mode, and several stability fixes
    Discord: contact list and add/delete, full history sync into LittleFS, chat with send and
    new-message push, and a gateway connection that starts when WiFi comes up (online inside the
    app, idle outside), closed cleanly before deep sleep. TLS is verified against embedded root
    certificates (discord_roots.h); the bot token lives in the gitignored discord_config.h.
    Power Mode: Balanced (unchanged), Power (never deep-sleeps), Eco (40 MHz, 5 FPS, watch face
    only, 5 s awake then deep sleep) with automatic switching at 3.45 V and a critical battery
    screen at 3.3 V. Also: menu scroll bar, auto-capitalised keyboard start, max WiFi TX power,
    and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
    [Restwise-watch.ino, discord_config.example.h, discord_roots.h]
2026-10-12 Map Discord 50278 error, log HTTP failures, add button diagnostics
    - dcErrorText: treat code 50278 like 50007 ("need a common server"), and
    show Discord's own message (ASCII, max 80 chars) for other error codes.
    - dcHttp: log "[DC] HTTP <code> <path> -> <body>" for any status >= 400.
    - Buttons: count raw level changes, accepted presses and presses taken by
    the UI per button; print one [BTN] line per press and add edges= to the
    [HB] health line, to tell a bouncing/dead switch from a software miss.
2026-10-28 Current-block screen, wake-to-block, no-radio build and a 2000-block timetable
    - Every wake (deep sleep and idle screen-off) checks the timetable first: a running block shows
    as an icon (book, bowl, moon, clock, car, bottle) with its start-end time and name; only a
    night Sleep block says "Good Night!". Otherwise the watchface.
    - The website now sends the block category (<days>:<category>|start|end|name) and the eight
    category names (C|key|Name lines); older firmware ignores both, so no flashing order is needed.
    - RESTWISE_NO_RADIO (build_config.h) strips WiFi, Discord, AI Chatbot, NTP and Dino;
    tools/build_variants.py compiles both builds from clean temp copies.
    - Timetable limit rai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
